kylerjkidd/Volta-Lab-Supply/README.md

# Volta-Lab-Supply
Programmable DC Power Supply
