kylerjkidd/Volta-Lab-Supply/Volta/Motherboard/REV A/Volta Block Diagram.png

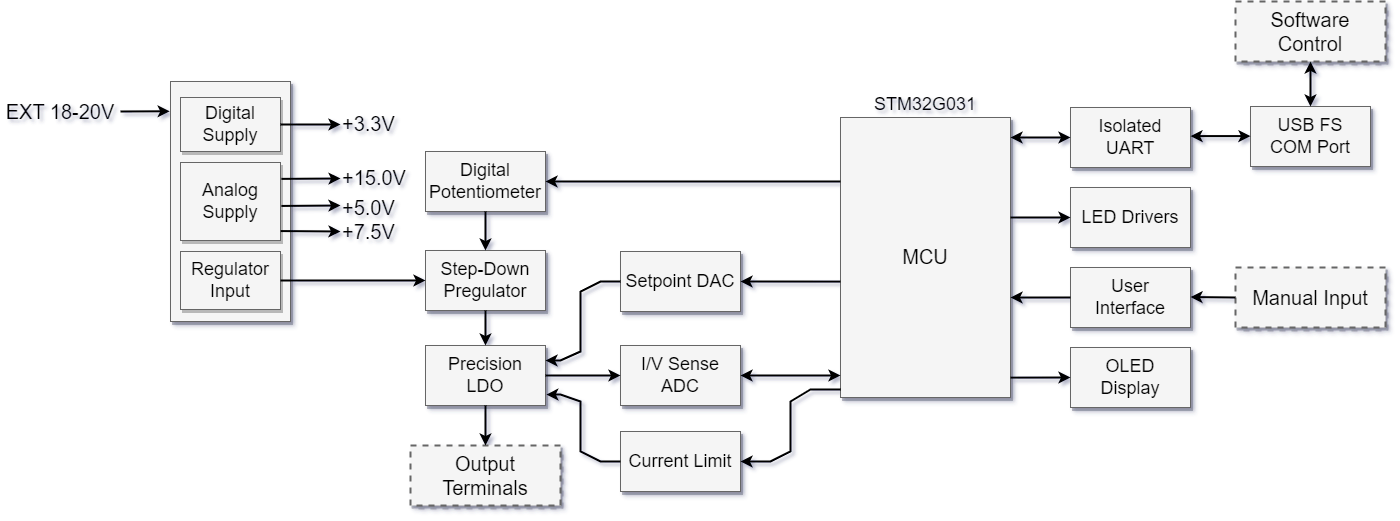
Volta/Motherboard/REV A/Volta Block Diagram.png
