kylerjkidd/Volta-Lab-Supply/Volta/Motherboard/REV A/PowerSupply-Motherboard-BOM.xlsx

Sheet: Part List Report
 |  |  | BILL OF MATERIALS |  | CIRCUIT CARD ASSEMBLY, VOLTA MOTHERBOARD
 | Part Number: |  | Volta Motherboard
 | Project: |  | "Volta Lab Bench Supply"
 | Rev: |  | A
 |  |  | Report Date: | 11/20/2022 | 2:24:57 PM
 |  |  | Print Date: | 2022-11-20 | 14:31:25
Quantity | # | Quantity | Designator | Comment | Part Number | Manufacturer | Description
5 | 1 | 5 | C1, C4, C39, C40, C43 | 10uF | GRM188C81A106MA73D | Murata Electronics | CAP CER 10UF 10V X6S 0603
16 | 2 | 16 | C2, C5, C6, C7, C9, C10, C13, C14, C15, C27, C33, C42, C44, C45, C46, C47 | 0.1uF | UMK105B7104KVHF, C0603C104K5RAC3121 | Taiyo Yuden, KEMET | CAP CER 0.1UF 50V X7R 0402, CAP CER 0.1UF 50V X7R 0603
7 | 3 | 7 | C3, C24, C30, C31, C36, C38, C41 | 4.7uF | GRM155C61E475ME15J | Murata Electronics | CAP MLCC 4.7UF 25V X5S 0402
5 | 4 | 5 | C8, C25, C26, C28, C34 | 0.01uF | HMR105B7103MV-F | Taiyo Yuden | CAP CER 0.01UF 100V X7R 0402
2 | 5 | 2 | C11, C12 | 47pF | C0402C470K5RACAUTO | KEMET | CAP CER 47PF 50V X7R 0402
10 | 6 | 10 | C16, C17, C18, C19, C20, C21, C22, C23, C29, C32 | 22uF | CL21A226MAYNNNE | Samsung Electro-Mechanics | CAP CER 22UF 25V X5R 0805
3 | 7 | 0 | C35, C37 | DNP | UMK105B7104KVHF | Taiyo Yuden | CAP CER 0.1UF 50V X7R 0402
1 | 8 | 1 | D1 | LED_Red | SM0603HCL | Bivar | LED HE RD 0603
3 | 9 | 3 | D2, D4, D6 | B240A-13-F | B240A-13-F | Diodes Incorporated | DIODE SCHOTTKY 40V 2A SMA
1 | 10 | 1 | D3 | SMAJE12AH | SMAJE12AH | Eaton - Electronics Division | TVS DIODE 12VWM UNI
1 | 11 | 1 | D5 | 1N4148 | 1N4148WS-G RVG | Taiwan Semiconductor | DIODE GEN PURP 75V 150MA SOD323
1 | 12 | 1 | D7 | BZT52-B7V5X | BZT52-B7V5X | Nexperia USA Inc. | DIODE ZENER 7.5V 590MW SOD123
1 | 13 | 1 | J1 | USB4105-GF-A | USB4105-GF-A | GCT | CONN RCP USB2.0 TYP C 24P SMD RA
2 | 14 | 2 | J2, J3 | CCSH-W10R-04TR-BK-A | CCSH-W10R-04TR-BK-A | JST | JST 4 PIN SMT CONN
1 | 15 | 1 | J4 | PJ-047A | PJ-047A | CUI Inc | CON PWR JCK 2.0 X 6.0MM W/SHLD 2.5A
1 | 16 | 1 | J5 | TSW-102-23-S-S | TSW-102-23-S-S | Samtec | CONN MALE HEADER 2 POS .100" T/H GOLD UNSHROUDED
1 | 17 | 1 | J6 | S2B-PH-SM4-TB(LF)(SN) | S2B-PH-SM4-TB(LF)(SN) | JST Sales America Inc. | CONN HEADER SMD R/A 2POS 2MM
2 | 18 | 2 | L1, L2 | 2.2uH | CIGT201610LH2R2MNE | Samsung Electro-Mechanics | FIXED IND 2.2UH 1.8A 139MOHM SMD
1 | 19 | 1 | L3 | 10uH | 74437368100 | Würth Elektronik | FIXED IND 10UH 5.2A 30 MOHM SMD
1 | 20 | 1 | L4 | 10uH | VLCF4020T-100MR85 | TDK | FIXED IND 10UH 850MA 185MOHM SMD
1 | 21 | 1 | Q1 | DMP3056L-7 | DMP3056L-7 | Diodes Incorporated | MOSFET P-CH 30V 4.3A SOT23
1 | 22 | 1 | Q2 | NPN | BCM847BV,115 | Nexperia USA | TRANS 2NPN 45V 0.1A SOT666
6 | 23 | 6 | R1, R2, R3, R33, R34, R39 | 1k | CR0402AFX-1001GLF | Bourns | RES 1K OHM 1% 1/16W 0402, RES SMD 1K OHM 1% 1/16W 0402
4 | 24 | 4 | R4, R5, R6, R7 | 2.7k | ERJ-2RKF2701X | Panasonic | RES SMD 2.7K OHM 1% 1/10W 0402
2 | 25 | 2 | R8, R11 | 27 | ERJ-2RKF27R0X | Panasonic | RES SMD 27 OHM 1% 1/10W 0402
2 | 26 | 2 | R9, R10 | 5.1k | CRCW04025K10FKED | Vishay / Dale | RES SMD 5.1K OHM 1% 1/16W 0402
2 | 27 | 2 | R12, R38 | 200k | CR0402-FX-2003GLF | Bourns | RES SMD 200K OHM 1% 1/16W 0402
4 | 28 | 4 | R13, R14, R16, R41 | 0 | CRCW04020000Z0EDC | Vishay / Dale | RES 0 OHM JUMPER 1/16W 0402
11 | 29 | 11 | R15, R20, R21, R22, R29, R35, R36, R37, R40, R46, R47 | 10k | CR0402-FX-1002GLF | Bourns | RES SMD 10K OHM 1% 1/16W 0402
2 | 30 | 0 | R17, R18 | DNP | CRCW06030000Z0EAHP | Vishay / Dale | RES SMD 0 OHM JUMPER 1/3W 0603
1 | 31 | 1 | R19 | 0.1 | ERJ-3RSFR10V | Panasonic Electronic Components | RES 0.1 OHM 1% 1/10W 0603
1 | 32 | 1 | R23 | 6.34k | ERJ-U02F6341X | Panasonic | RES SMD 6.34K OHM 1% 1/16W 0402
1 | 33 | 1 | R24 | 680 | CR0402-FX-6800GLF | Bourns | RES SMD 680 OHM 1% 1/16W 0402
 | 34 | 0 | R25 | DNP | CRCW04020000Z0EDC | Vishay / Dale | RES 0 OHM JUMPER 1/16W 0402
1 | 35 | 1 | R26 | 430 | CR0402-FX-4300GLF | Bourns Inc. | RES SMD 430 OHM 1% 1/16W 0402
1 | 36 | 1 | R27 | 10.2k | ERA-2APB1022X | Panasonic | RES SMD 10.2K OHM 0.1% 1/16W 0402
1 | 37 | 1 | R28 | 51k | ERA-2AEB513X | Panasonic | RES SMD 51K OHM 0.1% 1/16W 0402
1 | 38 | 1 | R30 | 100 | ERJ-2RKF1000X | Panasonic | RES SMD 100 OHM 1% 1/16W 0402
1 | 39 | 1 | R31 | 30.9k | ERJ-2RKF3092X | Panasonic | RES SMD 30.9K OHM 1% 1/16W 0402
1 | 40 | 1 | R32 | 59k | CRCW040259K0FKEDC | Vishay / Dale | RES SMD 59K OHM 1% 1/16W 0402
1 | 41 | 1 | R42 | 510 | RC0603FR-07510RL | YAGEO | RES 510 OHM 1% 1/10W 0603
1 | 42 | 1 | R43 | 100k | CR0402-FX-1003GLF | Bourns | RES SMD 100K OHM 1% 1/16W 0402
1 | 43 | 1 | R44 | 113k | CRCW0402113KFKED | Vishay / Dale | RES SMD 113K OHM 1% 1/16W 0402
1 | 44 | 1 | R45 | 1.2k | CR0402-FX-1201GLF | Bourns | RES SMD 1.2K OHM 1% 1/16W 0402
1 | 45 | 1 | S1 | SS312SAH4-R | SS312SAH4-R | NKK Switches | SWITCH SLIDE SPDT 0.4VA 28V
1 | 46 | 1 | U1 | SC16IS750IBS,128 | SC16IS750IBS,128 | NXP USA Inc. | IC UART I2C/SPI 24-HVQFN
1 | 47 | 1 | U2 | FT234XD | FT234XD-R | FTDI | IC USB SERIAL BASIC UART 12DFN
1 | 48 | 1 | U3 | MAX22421 | MAX22421BASA+ | Maxim Integrated | 2-CH 3KVRMS DIGITAL ISOLATOR
1 | 49 | 1 | U4 | LSF0102 | LSF0102QDCURQ1 | Texas Instruments | IC TRNSLTR BIDIRECTIONAL 8VSSOP
1 | 50 | 1 | U5 | LT3083 | LT3083EDF#PBF | Analog Devices Inc. | IC REG LINEAR POS ADJ 3A 12DFN
1 | 51 | 1 | U6 | ADP2303 | ADP2303ARDZ | Analog Devices Inc. | IC REG BUCK ADJUSTABLE 3A 8SOIC
1 | 52 | 1 | U7 | G3VM-31HR | G3VM-31HR | Omron Electronics Inc | SSR RELAY SPST-NO 4A 0-30V
1 | 53 | 1 | U8 | LMR12010 | LMR12010XMKE/NOPB | Texas Instruments | IC REG BUCK ADJ 1A TSOT23-6
1 | 54 | 1 | U9 | AD5245 | AD5245BRJZ10-R2 | Analog Devices Inc. | IC DGTL POT xKOHM 256TAP SOT23-8
2 | 55 | 2 | U10, U15 | LT1761 | LT1761ES5-BYP#TRMPBF | Linear Technology | IC REG LDO ADJ 0.1A TSOT23-5
1 | 56 | 1 | U11 | ADA4661-2 | ADA4661-2ARMZ-R7 | Analog Devices Inc. | IC CMOS 2 CIRCUIT 8MSOP
1 | 57 | 1 | U12 | MCP47CMB22 | MCP47CMB22-E/UN | Microchip Technology | IC DAC 12BIT DUAL V-OUT 10MSOP
1 | 58 | 1 | U13 | MCP1501T-20 | MCP1501T-20E/CHY | Microchip Technology | IC VREF SERIES 0.1% SOT23-6
1 | 59 | 1 | U14 | TLV431 | TLV431CDBZR | Texas Instruments | IC VREF SHUNT ADJ SOT23-3
1 | 60 | 1 | U16 | ADP121AUJZ-3.3-R7 | ADP121AUJZ-3.3-R7 | Analog Devices | IC REG LINEAR 3.3V 150MA TSOT5
1 | 61 | 1 | U17 | MCP6546 | MCP6546T-E/OT | Microchip Technology | IC COMP 1.6V SGL O-D SOT23-5
1 | 62 | 1 | U18 | INA293A | INA293A1QDBVRQ1 | Texas Instruments | IC CURR SENSE 1 CIRCUIT SOT23-5
1 | 63 | 1 | U19 | MCP3426 | MCP3426A0-E/MC | Microchip Technology | IC ADC 16BIT SIGMA-DELTA 8DFN
1 | 64 | 1 | Y1 | ASE-14.7456MHZ-LC-T | ASE-14.7456MHZ-LC-T | Abracon | XTAL OSC XO 14.7456MHZ CMOS SMD
 | 65 | 1 | N/A |  | Volta Motherboard | OSH PARK | PCB "Volta Lab Bench Supply"
 | Approved
 | Notes

Sheet: Project Information
Project Full Path | C:\Users\Implacable\Documents\Altium\_Projects\Power Supply\Motherboard\REV A\DSGN\PowerSupply-Motherboard.PrjPcb
Project Filename | PowerSupply-Motherboard.PrjPcb
Variant Name | None
Data-Source Filename | PowerSupply-Motherboard.PrjPcb
Data-Source Full Path | C:\Users\Implacable\Documents\Altium\_Projects\Power Supply\Motherboard\REV A\DSGN\PowerSupply-Motherboard.PrjPcb
Title | Bill of Materials For Project [PowerSupply-Motherboard.PrjPcb] (No PCB Document Selected)
Total Quantity | 134
Report Time | 2:24:57 PM
Report Date | 11/20/2022
Report Date & Tine | 11/20/2022 2:24:57 PM
Output Name | Bill of Materials
Output Type | BOM_PartType
Output Generator Name | BOM
Output Generator Description | Bill of Materials
