kylerjkidd/Volta-Lab-Supply/Volta/Motherboard/REV 02/PowerSupply-Motherboard-BOM.xlsx

Sheet: Part List Report
 |  |  | BILL OF MATERIALS |  | CIRCUIT CARD ASSEMBLY
 | Part Number: |  | Power Supply Motherboard
 | Project: |  | "Volta"
 | Rev: |  | 01
 |  |  | Report Date: | 8/24/2022 | 9:00:00 PM
 |  |  | Print Date: | 2022-08-25 | 20:26:04
Quantity | # | Quantity | Designator | Comment | Part Number | Manufacturer | Description
10 | 1 | 10 | C1, C9, C13, C14, C15, C16, C23, C25, C26, C36 | 2.2uF | GRM155R61E225KE11D | Murata Electronics | Multilayer Ceramic Capacitors MLCC - SMD/SMT 2.2UF 25V 10% 0402
20 | 2 | 20 | C2, C3, C4, C17, C18, C24, C27, C31, C33, C34, C38, C39, C40, C41, C42, C43, C44, C45, C46, C47 | 0.1uF | UMK105B7104KVHF | Taiyo Yuden | CAP CER 0.1UF 50V X7R 0402
5 | 3 | 5 | C5, C6, C10, C32, C35 | 0.01uF | HMR105B7103MV-F | Taiyo Yuden | CAP CER 0.01UF 100V X7R 0402
9 | 4 | 9 | C7, C8, C19, C20, C21, C22, C28, C29, C30 | 22uF | CL21A226MAYNNNE | Samsung Electro-Mechanics | CAP CER 22UF 25V X5R 0805
2 | 5 | 2 | C11, C12 | 47pF | C0402C470K5RACAUTO | KEMET | Multilayer Ceramic Capacitors MLCC - SMD/SMT 50Volt 47pF X7R 0402 10% AEC-Q200
2 | 6 | 0 | C37, R26 | DNP | UMK105B7104KVHF, CR0402-FX-1002GLF | Taiyo Yuden, Bourns | CAP CER 0.1UF 50V X7R 0402, Thick Film Resistors - SMD 10K OHM 1%
1 | 7 | 1 | D1 | 1N4148 | 1N4148WS-G RVG | Taiwan Semiconductor | Diodes - General Purpose, Power, Switching 100V, 0.15A, Switching Diode & Array
2 | 8 | 2 | D2, D9 | LED_GRN | SM0603HCL | Bivar | Standard LEDs - SMD HE Red 645 nm Water Clear
4 | 9 | 4 | D3, D5, D6, D8 | B240A-13-F | B240A-13-F | Diodes Incorporated | DIODE SCHOTTKY 40V 2A SMA
1 | 10 | 1 | D4 | BZT52-B7V5X | BZT52-B7V5X | Nexperia USA Inc. | DIODE ZENER 7.5V 590MW SOD123
1 | 11 | 1 | D7 | SMAJE12AH | SMAJE12AH | Eaton - Electronics Division | TVS DIODE 12VWM UNI
1 | 12 | 1 | F1 | 500mA PTC | MF-FSMF050X-2 | Bourns | 500mA PTC Fuse
1 | 13 | 1 | FB1 | Ferrite_Bead | BLM18AG102SH1D | Murata Electronics | Ferrite Beads 1000 OHM 25%
1 | 14 | 1 | J1 | USB4105-GF-A | USB4105-GF-A | GCT | USB-C (USB TYPE-C) USB 2.0 Receptacle Connector 24 (16+8 Dummy) Position Surface Mount, Right Angle; Through Hole
1 | 15 | 1 | J2 | PJ-047A | PJ-047A | CUI Inc | CON PWR JCK 2.0 X 6.0MM W/SHLD 2.5A
2 | 16 | 2 | J3, J7 | CCSH-W10R-04TR-BK-A | CCSH-W10R-04TR-BK-A | JST
1 | 17 | 1 | J4 | JST-PH-SMT
1 | 18 | 1 | J5 | TSW-102-xx-L-S | TSW-102-xx-L-S | Samtec | CONN MALE HEADER 2 POS .100" T/H GOLD UNSHROUDED
1 | 19 | 0 | J6 | DNP | 801-93-006-10-012000 | Mill-Max | CONN SOCKET STRIP LOPRO 6POS
1 | 20 | 1 | L1 | 10uH | VLCF4020T-100MR85 | TDK | Fixed Inductors 10uH 0.85A 4x4x2.0mm
2 | 21 | 2 | L2, L3 | 2.2uH | CIGT201610LH2R2MNE | Samsung Electro-Mechanics | FIXED IND 2.2UH 1.8A 139MOHM SMD
1 | 22 | 1 | L4 | 10uH | 74437368100 | Würth Elektronik | FIXED IND 10UH 5.2A 30 MOHM SMD
1 | 23 | 1 | Q1 | DMP3056L-7 | DMP3056L-7 | Diodes Incorporated | MOSFET P-CH 30V 4.3A SOT23
1 | 24 | 1 | Q2 | NPN | BCM847BV,115 | Nexperia USA | TRANS 2NPN 45V 0.1A SOT666
7 | 25 | 7 | R1, R28, R30, R32, R33, R36, R40 | 1k | CR0402AFX-1001GLF | Bourns | Thick Film Resistors - SMD Resistor 0402 1k 1% 63mW TC100, Thick Film Resistors - SMD ResA 0402 1k 1% 63mW TC100
1 | 26 | 1 | R2 | 30.9k | ERJ-2RKF3092X | Panasonic | Thick Film Resistors - SMD 0402 30.9Kohms 1% AEC-Q200
1 | 27 | 1 | R3 | 59k | CRCW040259K0FKEDC | Vishay / Dale | Thick Film Resistors - SMD 1/16watt 59K ohms 1% Commercial Use
12 | 28 | 12 | R4, R6, R10, R14, R15, R20, R21, R35, R39, R42, R49, R50 | 10k | CR0402-FX-1002GLF | Bourns | Thick Film Resistors - SMD 10K OHM 1%
2 | 29 | 2 | R5, R9 | 27 | ERJ-2RKF27R0X | Panasonic | Thick Film Resistors - SMD 0402 27.0ohms 1% Tol AEC-Q200
2 | 30 | 2 | R7, R8 | 5.1k | CRCW04025K10FKED | Vishay / Dale | Thick Film Resistors - SMD 1/16watt 5.1Kohms 1%
1 | 31 | 1 | R11 | 510 | RC0603FR-07510RL | YAGEO | Thick Film Resistors - SMD 510 Ohms 100mW 0603 1%
1 | 32 | 1 | R12 | 0 | CRCW04020000Z0EDC | Vishay / Dale | Thick Film Resistors - SMD 1/16watt 0ohm Commercial Use
1 | 33 | 1 | R13 | 113k | CRCW0402113KFKED | Vishay / Dale | Thick Film Resistors - SMD 1/16 Watt 113K ohms 1%
1 | 34 | 1 | R16 | 0.5 | PT1206FR-7W0R5L | YAGEO | Current Sense Resistors - SMD 500 mOhms 500mW 1 % 75 ppm/C AEC-Q200
4 | 35 | 4 | R17, R18, R43, R44 | 2.7k | ERJ-2RKF2701X | Panasonic | Thick Film Resistors - SMD 0402 2.7Kohms 1% AEC-Q200
2 | 36 | 2 | R19, R31 | 24k | RT0402BRD0724KL | YAGEO | Thin Film Resistors - SMD 1/16W 24K ohm 0.1% 25ppm
1 | 37 | 1 | R22 | 9.1k | ERA-2AEB912X | Panasonic | Thin Film Resistors - SMD 0402 1/16W 9.1Kohms
2 | 38 | 2 | R23, R34 | 10.2k | ERA-2APB1022X | Panasonic | Thin Film Resistors - SMD 0402 10.2Kohms 0.1% .063W 15ppm AEC-Q200
5 | 39 | 5 | R24, R37, R38, R41, R45 | 51k | ERA-2AEB513X | Panasonic | Thin Film Resistors - SMD 0402 1/16W 51Kohms 0.1%
1 | 40 | 1 | R25 | 6.34k | ERJ-U02F6341X | Panasonic | Thick Film Resistors - SMD 0402 1% 6.34Kohm Anti-Sulfur AEC-Q200
1 | 41 | 1 | R27 | 680 | CR0402-FX-6800GLF | Bourns | Thick Film Resistors - SMD 680 OHM 1%
1 | 42 | 1 | R29 | 100 | ERJ-2RKF1000X | Panasonic | Thick Film Resistors - SMD 0402 100ohms 1% AEC-Q200
2 | 43 | 2 | R46, R47 | 10 | ESR01MZPF10R0 | ROHM Semiconductor | Thick Film Resistors - SMD 0402 10ohm 1% Anti Surge AEC-Q200
1 | 44 | 1 | R48 | 56k | CR0402-FX-5602GLF | Bourns | Thick Film Resistors - SMD 56K OHM 1%
1 | 45 | 1 | S1 | SS312SAH4-R | SS312SAH4-R | NKK Switches | Slide Switch SPDT Surface Mount, Right Angle
1 | 46 | 1 | S2 | KMR243GLFG | KMR243GFLG | C&K | Tactile Switch SPST-NO Top Actuated Surface Mount
1 | 47 | 1 | U1 | LMR12010 | LMR12010XMKE/NOPB | Texas Instruments | IC REG BUCK ADJ 1A TSOT23-6
2 | 48 | 2 | U2, U6 | LT1761 | LT1761ES5-BYP#TRMPBF | Linear Technology | IC REG LDO ADJ 0.1A TSOT23-5
1 | 49 | 1 | U3 | USBLC6 | USBLC6-2SC6 | STMicroelectronics | IC ESD PROTECTION LO CAP SOT23-6
1 | 50 | 1 | U4 | FT234XD | FT234XD-R | FTDI | IC USB SERIAL BASIC UART 12DFN
1 | 51 | 1 | U5 | MAX22421 | MAX22421BASA+ | Maxim Integrated | 2-CH 3KVRMS DIGITAL ISOLATOR
1 | 52 | 1 | U7 | ADP121AUJZ-3.3-R7 | ADP121AUJZ-3.3-R7 | Analog Devices | IC REG LINEAR 3.3V 150MA TSOT5
1 | 53 | 1 | U8 | LT3083 | LT3083EDF#PBF | Analog Devices Inc. | Linear Voltage Regulator IC Positive Adjustable 1 Output 3A 12-DFN (4x4)
1 | 54 | 1 | U9 | ADP2303 | ADP2303ARDZ | Analog Devices Inc. | IC REG BUCK ADJUSTABLE 3A 8SOIC
1 | 55 | 1 | U10 | STM32G031F6P6 | STM32G031F6P6 | STMicroelectronics | IC MCU 32BIT 32KB FLASH 20TSSOP
1 | 56 | 1 | U11 | MCP6L2T | MCP6L2T-E/MS | Microchip Technology | IC OPAMP GP 2 CIRCUIT 8MSOP
1 | 57 | 1 | U12 | AD5245 | AD5245BRJZ10-R2 | Analog Devices Inc. | Digital Potentiometer 10k Ohm 1 Circuit 256 Taps I²C Interface SOT-23-8
1 | 58 | 1 | U13 | ADA4661-2 | ADA4661-2ARMZ-R7 | Analog Devices Inc. | IC CMOS 2 CIRCUIT 8MSOP
1 | 59 | 1 | U14 | MCP1501T-20 | MCP1501T-20E/CHY | Microchip Technology | IC VREF SERIES 0.1% SOT23-6
1 | 60 | 1 | U15 | MCP47CVB21 | MCP47CVB21-E/UN | Microchip Technology | IC DAC 12BIT V-OUT 10MSOP
1 | 61 | 1 | U16 | MCP9804 | MCP9804T-E/MC | Microchip Technology | SENSOR DIGITAL -40C-125C 8DFN
1 | 62 | 1 | U17 | MCP6546 | MCP6546T-E/OT | Microchip Technology | IC COMP 1.6V SGL O-D SOT23-5
1 | 63 | 1 | U18 | INA219 | INA219AIDCNR | Texas Instruments | Current Monitor Regulator High-Side 10mA SOT-23-8
1 | 64 | 1 | Y1 | ASE-12.000-MHZ-E-T | ASE-12.000-MHZ-E-T | Abracon | OSC XO 12.000MHZ CMOS SMD
 | 65 | 1 | N/A |  | Power Supply Motherboard | OSH PARK | PCB "Volta"
 | Approved
 | Notes

Sheet: Project Information
Project Full Path | C:\Users\Implacable\Documents\Altium\_Projects\Power Supply\Motherboard\DSGN\PowerSupply-Motherboard.PrjPcb
Project Filename | PowerSupply-Motherboard.PrjPcb
Variant Name | None
Data-Source Filename | PowerSupply-Motherboard.PrjPcb
Data-Source Full Path | C:\Users\Implacable\Documents\Altium\_Projects\Power Supply\Motherboard\DSGN\PowerSupply-Motherboard.PrjPcb
Title | Bill of Materials For Project [PowerSupply-Motherboard.PrjPcb] (No PCB Document Selected)
Total Quantity | 146
Report Time | 9:00:00 PM
Report Date | 8/24/2022
Report Date & Tine | 8/24/2022 9:00:00 PM
Output Name | Bill of Materials
Output Type | BOM_PartType
Output Generator Name | BOM
Output Generator Description | Bill of Materials
