kylerjkidd/Volta-Lab-Supply/Volta/Interface/REV 02/Volta-Interface.xlsx

Sheet: Part List Report
 |  |  | BILL OF MATERIALS |  | CIRCUIT CARD ASSEMBLY
 | Part Number: |  | Volta-Interface
 | Project: |  | Volta Front Panel Interface
 | Rev: |  | 02
 |  |  | Report Date: | 10/7/2023 | 5:27 PM
 |  |  | Print Date: | 2023-10-08 | 11:28:17
Quantity | # | Quantity | Designator | Comment | Part Number | Manufacturer | Description
12 | 1 | 12 | C1, C3, C4, C5, C6, C7, C10, C11, C12, C13, C15, C18 | 2.2uF | GRM155R61E225KE11D, GRM188C81A106MA73D | Murata Electronics | Multilayer Ceramic Capacitors MLCC - SMD/SMT 2.2UF 25V 10% 0402, CAP CER 10UF 10V X6S 0603
3 | 2 | 3 | C2, C14, C16 | 0.1uF | UMK105B7104KVHF | Taiyo Yuden | CAP CER 0.1UF 50V X7R 0402
3 | 3 | 3 | C8, C9, C17 | 0.01uF | HMR105B7103MV-F | Taiyo Yuden | CAP CER 0.01UF 100V X7R 0402
1 | 4 | 1 | C19 | 10uF | GRM188C81A106MA73D | Murata Electronics | CAP CER 10UF 10V X6S 0603
3 | 5 | 3 | D1, D2, D3 | LED |  |  | LED
1 | 6 | 1 | D4 | LED_GRN | SM0603HCL | Bivar | Standard LEDs - SMD HE Red 645 nm Water Clear
1 | 7 | 1 | J1 | CCSH-W10R-04TR-BK-A | CCSH-W10R-04TR-BK-A | JST
1 | 8 | 1 | J2 | ER-CON30HT-1 | ER-CON30HT-1 | EastRising Technology | 30 PINS 0.5 PITCH SMD TOP CONTACT CONN
1 | 9 | 0 | J3 | DNP | 801-93-006-10-012000 | Mill-Max | CONN SOCKET STRIP LOPRO 6POS
2 | 10 | 0 | R1, R2 | DNP | CRCW04020000Z0EDC | Vishay / Dale | Thick Film Resistors - SMD 1/16watt 0ohm Commercial Use
8 | 11 | 8 | R3, R4, R5, R6, R7, R8, R12, R13 | 10k | CR0402-FX-1002GLF, KTR03EZPJ512 | Bourns, ROHM Semiconductor | Thick Film Resistors - SMD 10K OHM 1%, Thick Film Resistors - SMD 0603 5.1Kohm 5% High Voltage
2 | 12 | 2 | R9, R10 | 2.7k | ERJ-2RKF2701X | Panasonic | Thick Film Resistors - SMD 0402 2.7Kohms 1% AEC-Q200
1 | 13 | 1 | R11 | 1k | CR0402AFX-1001GLF | Bourns | Thick Film Resistors - SMD ResA 0402 1k 1% 63mW TC100
1 | 14 | 1 | R14 | 390k | KTR03EZPJ512 | ROHM Semiconductor | Thick Film Resistors - SMD 0603 5.1Kohm 5% High Voltage
3 | 15 | 3 | S1, S3, S4 | B3F-105X | B3F-105X | Omron Electronics Inc-EMC Div | SWITCH TACTILE SPST-NO 0.05A 24V
1 | 16 | 1 | S2 | PEC11R-4115F-S0018 | PEC11R-4115F-S0018 | Bourns | ROTARY ENCODER MECHANICAL XXPPR
1 | 17 | 1 | S5 | KMR243GLFG | KMR243GFLG | C&K | Tactile Switch SPST-NO Top Actuated Surface Mount
1 | 18 | 1 | U1 | IS31FL3193 | IS31FL3193-DLS2-TR | Lumissil Microsystems | IC LED DRIVER LINEAR 42MA 10DFN
1 | 19 | 1 | U2 | STM32G031F6P6 | STM32G031F6P6 | STMicroelectronics | IC MCU 32BIT 32KB FLASH 20TSSOP
1 | 20 | 1 | Y1 | ASE-12.000-MHZ-E-T | ASE-12.000-MHZ-E-T | Abracon | OSC XO 12.000MHZ CMOS SMD
 | 21 | 1 | N/A |  | Volta-Interface | OCEAN INSIGHT | PCB Volta Front Panel Interface
 | Approved
 | Notes

Sheet: Project Information
Project Full Path | C:\Users\Implacable\Documents\_Github\Volta\Interface\REV 01\Volta-Inteface.PrjPcb
Project Filename | Volta-Inteface.PrjPcb
Variant Name | None
Data-Source Filename | Volta-Inteface.PrjPcb
Data-Source Full Path | C:\Users\Implacable\Documents\_Github\Volta\Interface\REV 01\Volta-Inteface.PrjPcb
Title | Bill of Materials for Project [Volta-Inteface.PrjPcb] (No PCB Document Selected)
Total Quantity | 48
Report Time | 5:27 PM
Report Date | 10/7/2023
Report Date & Tine | 10/7/2023 5:27 PM
Output Name | Bill of Materials
Output Type | BomReport
Output Generator Name | BOM
Output Generator Description | Bill of Materials
