kylerjkidd/Volta-Lab-Supply/Volta/Interface/REV A/Volta-Interface.xlsx

Sheet: Part List Report
 |  |  | BILL OF MATERIALS |  | CIRCUIT CARD ASSEMBLY
 | Part Number: |  | Volta-Interface
 | Project: |  | Volta Front Panel Interface
 | Rev: |  | A
 |  |  | Report Date: | 10/8/2023 | 2:31 PM
 |  |  | Print Date: | 2023-10-08 | 11:33:11
Quantity | # | Quantity | Designator | Comment | Part Number | Manufacturer | Description
10 | 1 | 10 | C1, C3, C6, C8, C14, C15, C16, C17, C19, C23 | 2.2uF | GRM155R61E225KE11D | Murata Electronics | CAP CER 2.2UF 25V X5R 0402
10 | 2 | 10 | C2, C4, C5, C7, C9, C10, C11, C18, C20, C21 | 0.1uF | UMK105B7104KVHF, GRM155R61E225KE11D | Taiyo Yuden | CAP CER 0.1UF 50V X7R 0402
3 | 3 | 3 | C12, C13, C22 | 0.01uF | HMR105B7103MV-F | Taiyo Yuden | CAP CER 0.01UF 100V X7R 0402
1 | 4 | 1 | C24 | 10uF | CL05A106MP8NUB8 | Samsung Electro-Mechanics | CAP CER 10UF 10V X5R 0402
2 | 5 | 2 | D1, D4 | XZMOK53W-8 | XZMOK53W-8 | SunLED | LED ORANGE CLEAR CHIP SMD
2 | 6 | 2 | D2, D5 | XZM2ACR53W-8 | XZM2ACR53W-8 | SunLED | LED RED CLEAR CHIP SMD
2 | 7 | 2 | D3, D6 | XZVG53W-8 | XZVG53W-8 | SunLED | LED GREEN CLEAR CHIP SMD
1 | 8 | 1 | D7 | LED_Red | SM0603HCL | Bivar | LED HE RD 0603
1 | 9 | 1 | J1 | CCSH-W10R-04TR-BK-A | CCSH-W10R-04TR-BK-A | JST | JST 4 PIN SMT CONN
1 | 10 | 1 | J2 | ER-CON30HT-1 | ER-CON30HT-1 | EastRising Technology | 30 PINS 0.5 PITCH SMD TOP CONTACT CONN
5 | 11 | 5 | R1, R2, R3, R4, R11 | 100 | ERJ-2RKF1000X | Panasonic | RES SMD 100 OHM 1% 1/16W 0402
2 | 12 | 0 | R5, R8 | DNP | CRCW04020000Z0EDC | Vishay / Dale | RES 0 OHM JUMPER 1/16W 0402
7 | 13 | 7 | R6, R7, R9, R10, R14, R16, R17 | 10k | CR0402-FX-1002GLF | Bourns | RES SMD 10K OHM 1% 1/16W 0402
2 | 14 | 2 | R12, R13 | 2.7k | ERJ-2RKF2701X | Panasonic | RES SMD 2.7K OHM 1% 1/10W 0402
1 | 15 | 1 | R15 | 1k | CR0402AFX-1001GLF | Bourns | RES 1K OHM 1% 1/16W 0402
1 | 16 | 1 | R18 | 390k | CR0402-FX-3903GLF | Bourns Inc. | RES SMD 390K OHM 1% 1/16W 0402
4 | 17 | 4 | S1, S2, S3, S4 | B3F-105X | B3F-105X | Omron Electronics Inc-EMC Div | SWITCH TACTILE SPST-NO 0.05A 24V
1 | 18 | 1 | S5 | PEC11R-4115F-S0018 | PEC11R-4115F-S0018 | Bourns | ROTARY ENCODER MECHANICAL XXPPR
1 | 19 | 1 | S6 | KMR243GLFG | KMR243GLFG | C&K | SWITCH TACTILE SPST-NO 0.01A 32V
2 | 20 | 2 | U1, U2 | IS31FL3193 | IS31FL3193-DLS2-TR | Lumissil Microsystems | IC LED DRIVER LINEAR 42MA 10DFN
1 | 21 | 1 | U3 | STM32G031F8P6 | STM32G031F8P6 | STMicroelectronics | IC MCU 32BIT 64KB FLASH 20TSSOP
1 | 22 | 1 | Y1 | ASE-10.000MHZ-LC-T | ASE-10.000MHZ-LC-T | Abracon | OSC XO 10.000MHZ CMOS SMD
 | 23 | 1 | N/A |  | Volta-Interface |  | PCB Volta Front Panel Interface
 | Approved
 | Notes

Sheet: Project Information
Project Full Path | C:\Users\Implacable\Documents\_Github\Volta\Interface\REV A\DSGN\Volta-Inteface.PrjPcb
Project Filename | Volta-Inteface.PrjPcb
Variant Name | None
Data-Source Filename | Volta-Inteface.PrjPcb
Data-Source Full Path | C:\Users\Implacable\Documents\_Github\Volta\Interface\REV A\DSGN\Volta-Inteface.PrjPcb
Title | Bill of Materials for Project [Volta-Inteface.PrjPcb] (No PCB Document Selected)
Total Quantity | 61
Report Time | 2:31 PM
Report Date | 10/8/2023
Report Date & Tine | 10/8/2023 2:31 PM
Output Name | Bill of Materials
Output Type | BomReport
Output Generator Name | BOM
Output Generator Description | Bill of Materials
