kylerjkidd/Volta-Lab-Supply/Volta/Motherboard/REV 02/Changes.docx

Changes from Volta-Motherboard Rev 01

- Adjusted the front facing board outline to support larger front panel CCA
- Changed U10 to STM32G031F8P6 to increase program flash
- Changed U15 to MCP47CMB22 to improve the DC precision and resolution of the current limit setpoint
- ILIM now comes from a dedicated DAC
- MCP6L2T replaced with TLV272 due to product availability
- Current sense resistor value changed to 0.33 Ohm
- Differential amplifier gain increased to 10V/V
