kylerjkidd/Volta-Lab-Supply/Volta/Interface/REV 02/Changes.docx

Changes from Volta-Interface Rev 01

- Increased board dimensions to 90x26mm
- Increased clearances around the rotary encoder
- Shifted position of binding posts, encoder and switches
- Reduced backplane drill size for binding posts
- Adjusted display connector position and increased clearance
- Added soft-start capacitor to the reset line on the display
- Changed U2 to STM32G031F8P6 to increase program flash
