kylerjkidd/Volta-Lab-Supply/Volta/Interface/REV A/Changes.docx

Changes from Volta-Interface Rev 02

- Added additional trim adjust button
- Shifted position of buttons to fit additional button
- Moved to 4 layers to improve routing
- Additional LEDs fitted for more indicator lights (FAULT/CLAMP, SET MODE, SERIAL)
- Added series resistors to debounce capacitors to protect switch terminals
- Removed extraneous bias resistor
- Added support for Tag-Connect programming cable
