kylerjkidd/Volta-Lab-Supply/Volta/Prototyping/Volta-Digital-SCH_(01).pdf

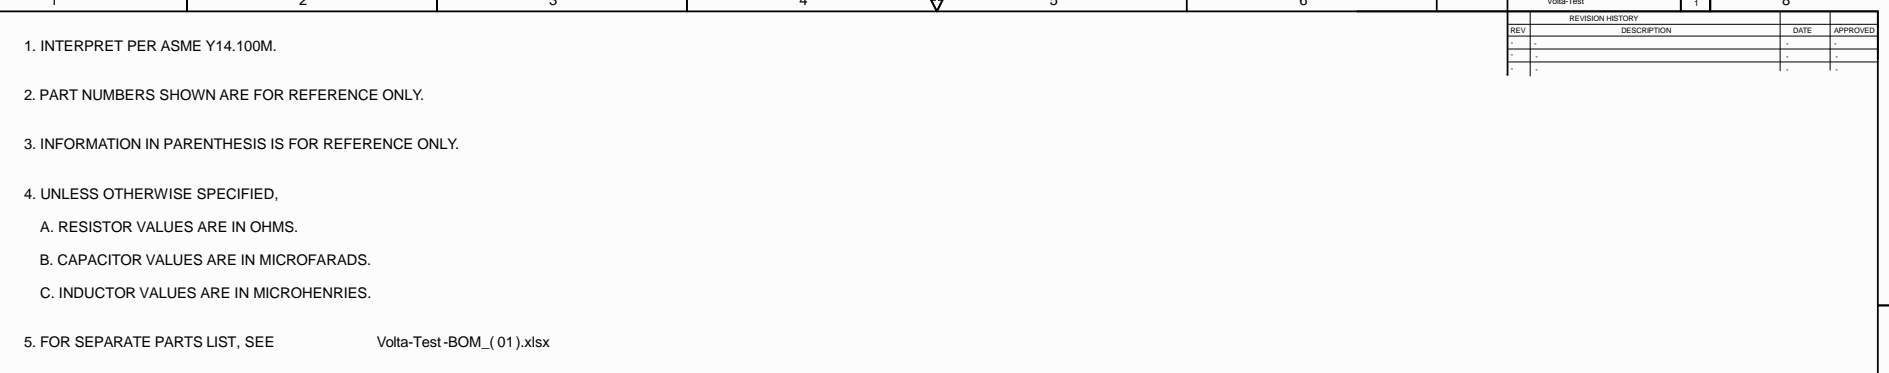
[picture p2: page 1]

DWG NO Volta-Test | SH

REVISION HISTORY

REV | DESCRIPTION | DATE | APPROVED
- | - | - -

2. PART NUMBERS SHOWN ARE FOR REFERENCE ONLY.

3. INFORMATION IN PARENTHESIS IS FOR REFERENCE ONLY.

A. RESISTOR VALUES ARE IN OHMS.

B. CAPACITOR VALUES ARE IN MICROFARADS.

C. INDUCTOR VALUES ARE IN MICROHENRIES.

5. FOR SEPARATE PARTS LIST, SEE

MATERIAL: | DO NOT SCALE DRAWING UNLESS OTHERWISE SPECIFIED, DIMENSIONS ARE IN TOLERANCES: .X +/- 0.1 .XX +/- 0.01 .XXX +/- 0.001 | DFTG | K. KIDD | -

ENG | K. KIDD | -
MECH | * | *

MFG | * | *

THIRD ANGLE PROJECTION | ALL SHEETS ARE THE SAME REVISION STATUS

SIZE D | DRAWING NUMBER Volta-Test | REV 01

SCALE N/A | | 1 3 SHEET OF

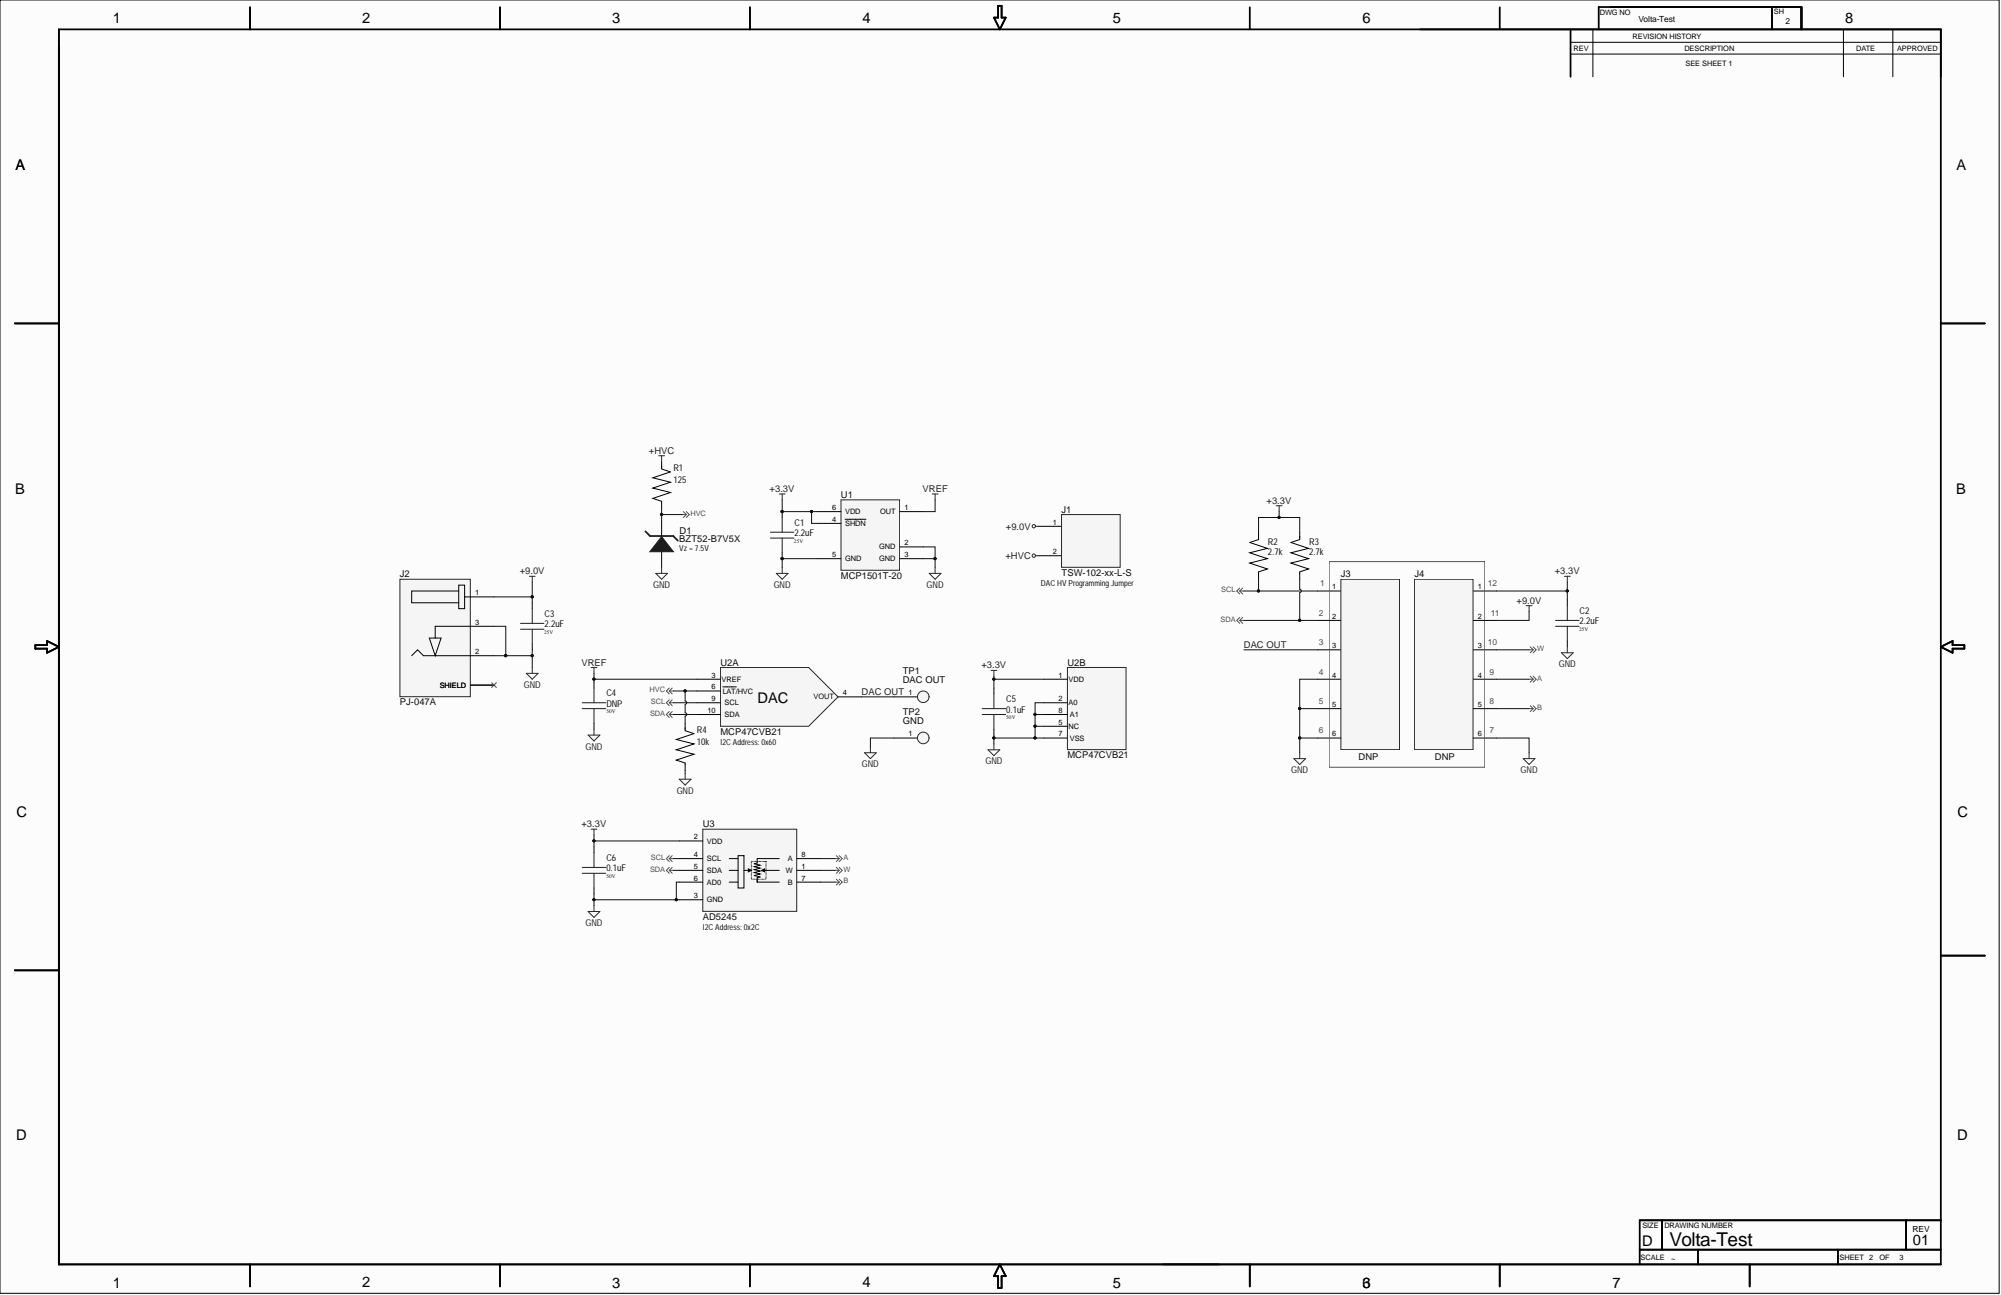
[picture p3: page 2]

D W G N O Volta-Tes t | SH 2

REVISI O N H IST O R Y

REV | DESC R IPTI O N | D ATE | APPR OVED

DAC HV Programming Jumper

SIZE D | G D R AW I N N U MBER | REV

SCALE ~ | | 2 SHEET O F
