kylerjkidd/Volta-Lab-Supply/Volta/Prototyping/Volta-Display-SCH_(01).pdf

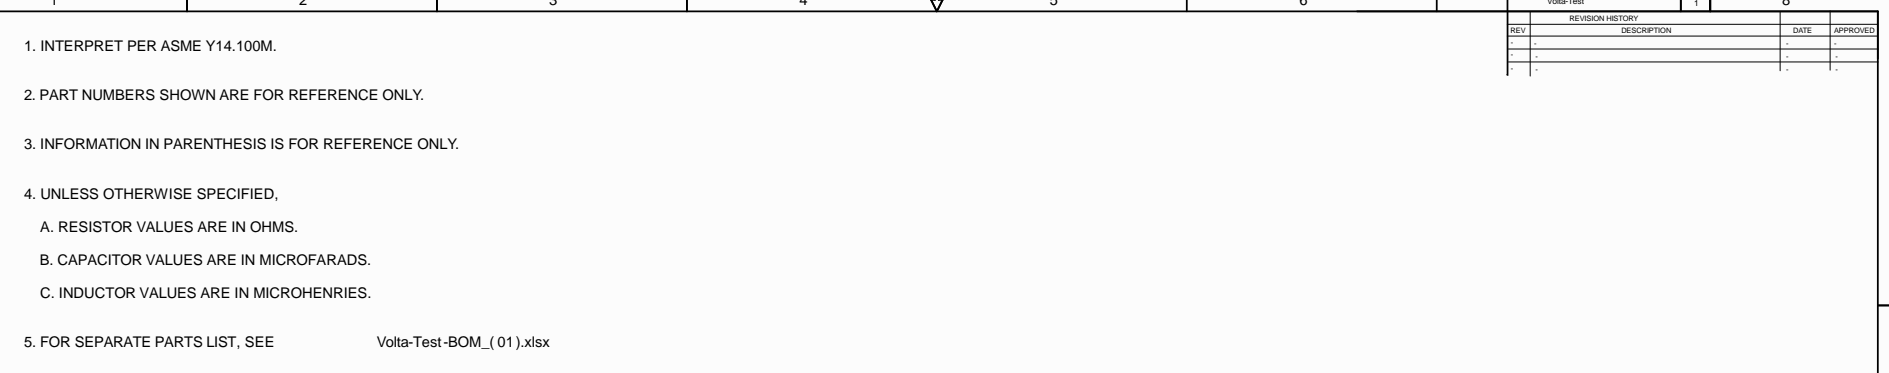
[picture p4: page 1]

DWG NO Volta-Test | SH

REVISION HISTORY

REV | DESCRIPTION | DATE | APPROVED
- | - | - -

2. PART NUMBERS SHOWN ARE FOR REFERENCE ONLY.

3. INFORMATION IN PARENTHESIS IS FOR REFERENCE ONLY.

A. RESISTOR VALUES ARE IN OHMS.

B. CAPACITOR VALUES ARE IN MICROFARADS.

C. INDUCTOR VALUES ARE IN MICROHENRIES.

5. FOR SEPARATE PARTS LIST, SEE

MATERIAL: | DO NOT SCALE DRAWING UNLESS OTHERWISE SPECIFIED, DIMENSIONS ARE IN TOLERANCES: .X +/- 0.1 .XX +/- 0.01 .XXX +/- 0.001 | DFTG | K. KIDD | -

ENG | K. KIDD | -
MECH | * | *

MFG | * | *

THIRD ANGLE PROJECTION | ALL SHEETS ARE THE SAME REVISION STATUS

SIZE D | DRAWING NUMBER Volta-Test | REV 01

SCALE N/A | | 1 3 SHEET OF

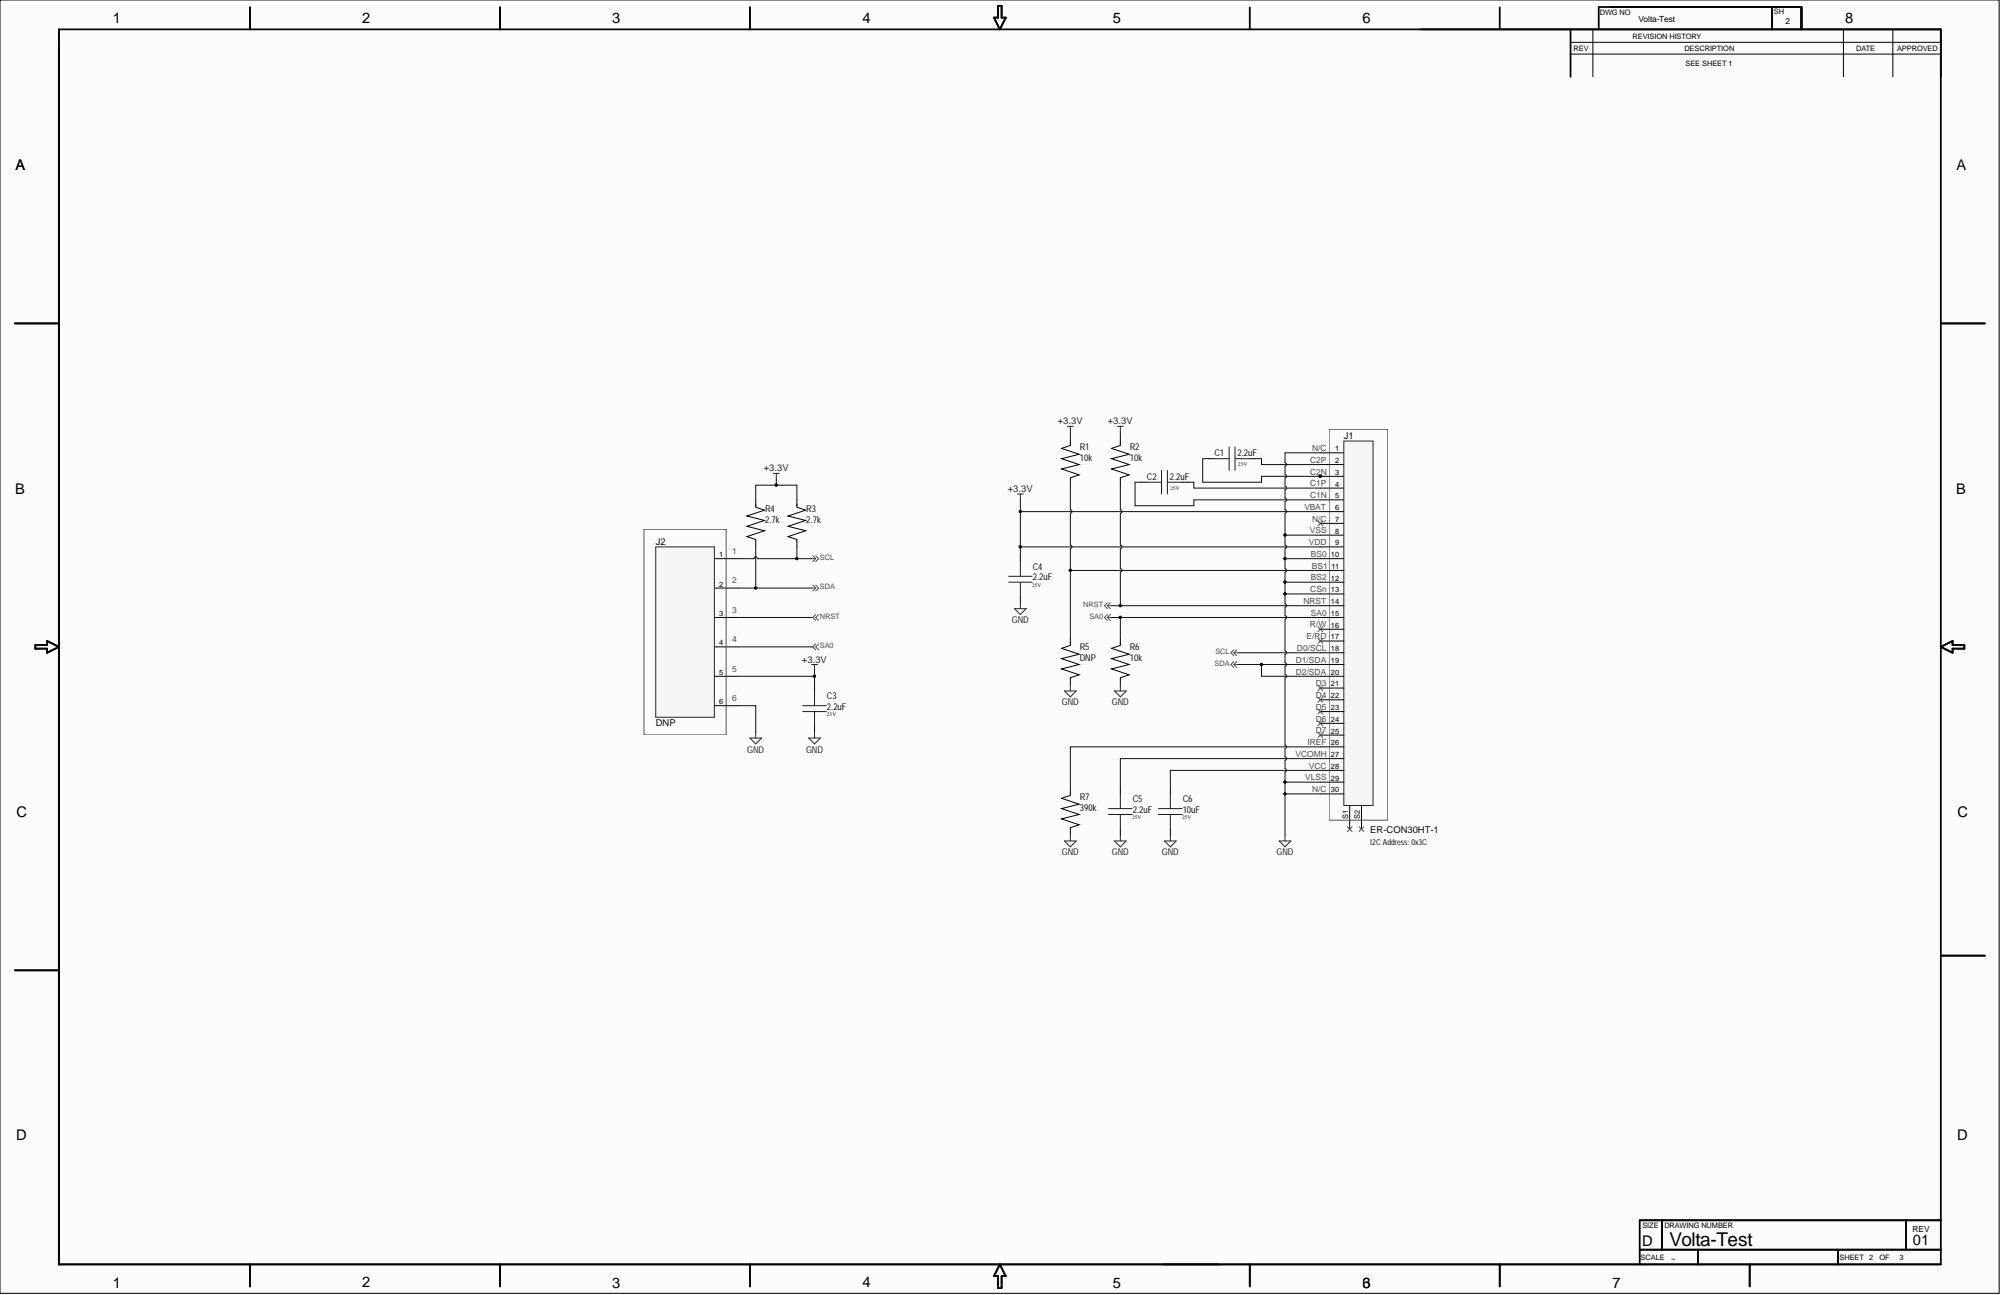
[picture p5: page 2]

D W G N O Volta-Tes t | SH 2

REVISI O N H IST O R Y

REV | DESC R IPTI O N | D ATE | APPR OVED

C2P
C2N
C1P
C1N

N/C VSS

VDD
BS0 | 1011
BS1
BS2 | 12
CSn | 13
14 15 16

D1/SDA | 19
D2/SDA | 20
D3 IREF | 21

VCOMH | 27
VCC | 28
VLSS | 29
N/C
30

SIZE D | G D R AW I N N U MBER | REV

SCALE ~ | | 2 SHEET O F
