kylerjkidd/Volta-Lab-Supply/Volta/Prototyping/Volta-Interposer-SCH_(01).pdf

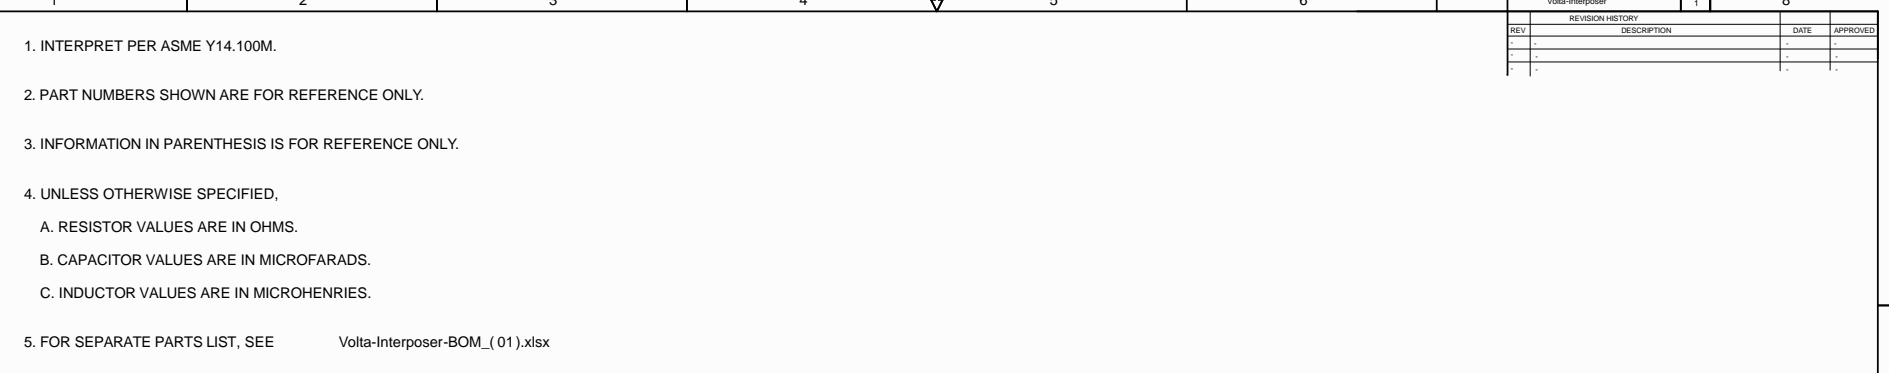
[picture p6: page 1]

DWG NO Volta-Interposer | SH

REVISION HISTORY

REV | DESCRIPTION | DATE | APPROVED
- | - | - -

2. PART NUMBERS SHOWN ARE FOR REFERENCE ONLY.

3. INFORMATION IN PARENTHESIS IS FOR REFERENCE ONLY.

A. RESISTOR VALUES ARE IN OHMS.

B. CAPACITOR VALUES ARE IN MICROFARADS.

C. INDUCTOR VALUES ARE IN MICROHENRIES.

5. FOR SEPARATE PARTS LIST, SEE

MATERIAL: | DO NOT SCALE DRAWING UNLESS OTHERWISE SPECIFIED, DIMENSIONS ARE IN TOLERANCES: .X +/- 0.1 .XX +/- 0.01 .XXX +/- 0.001 | DFTG | K. KIDD | 10/09/2022

ENG | K. KIDD | 10/09/2022
MECH | * | *

MFG | * | *

THIRD ANGLE PROJECTION | ALL SHEETS ARE THE SAME REVISION STATUS

SIZE D | DRAWING NUMBER Volta-Interposer | REV 01

SCALE N/A | | 1 3 SHEET OF

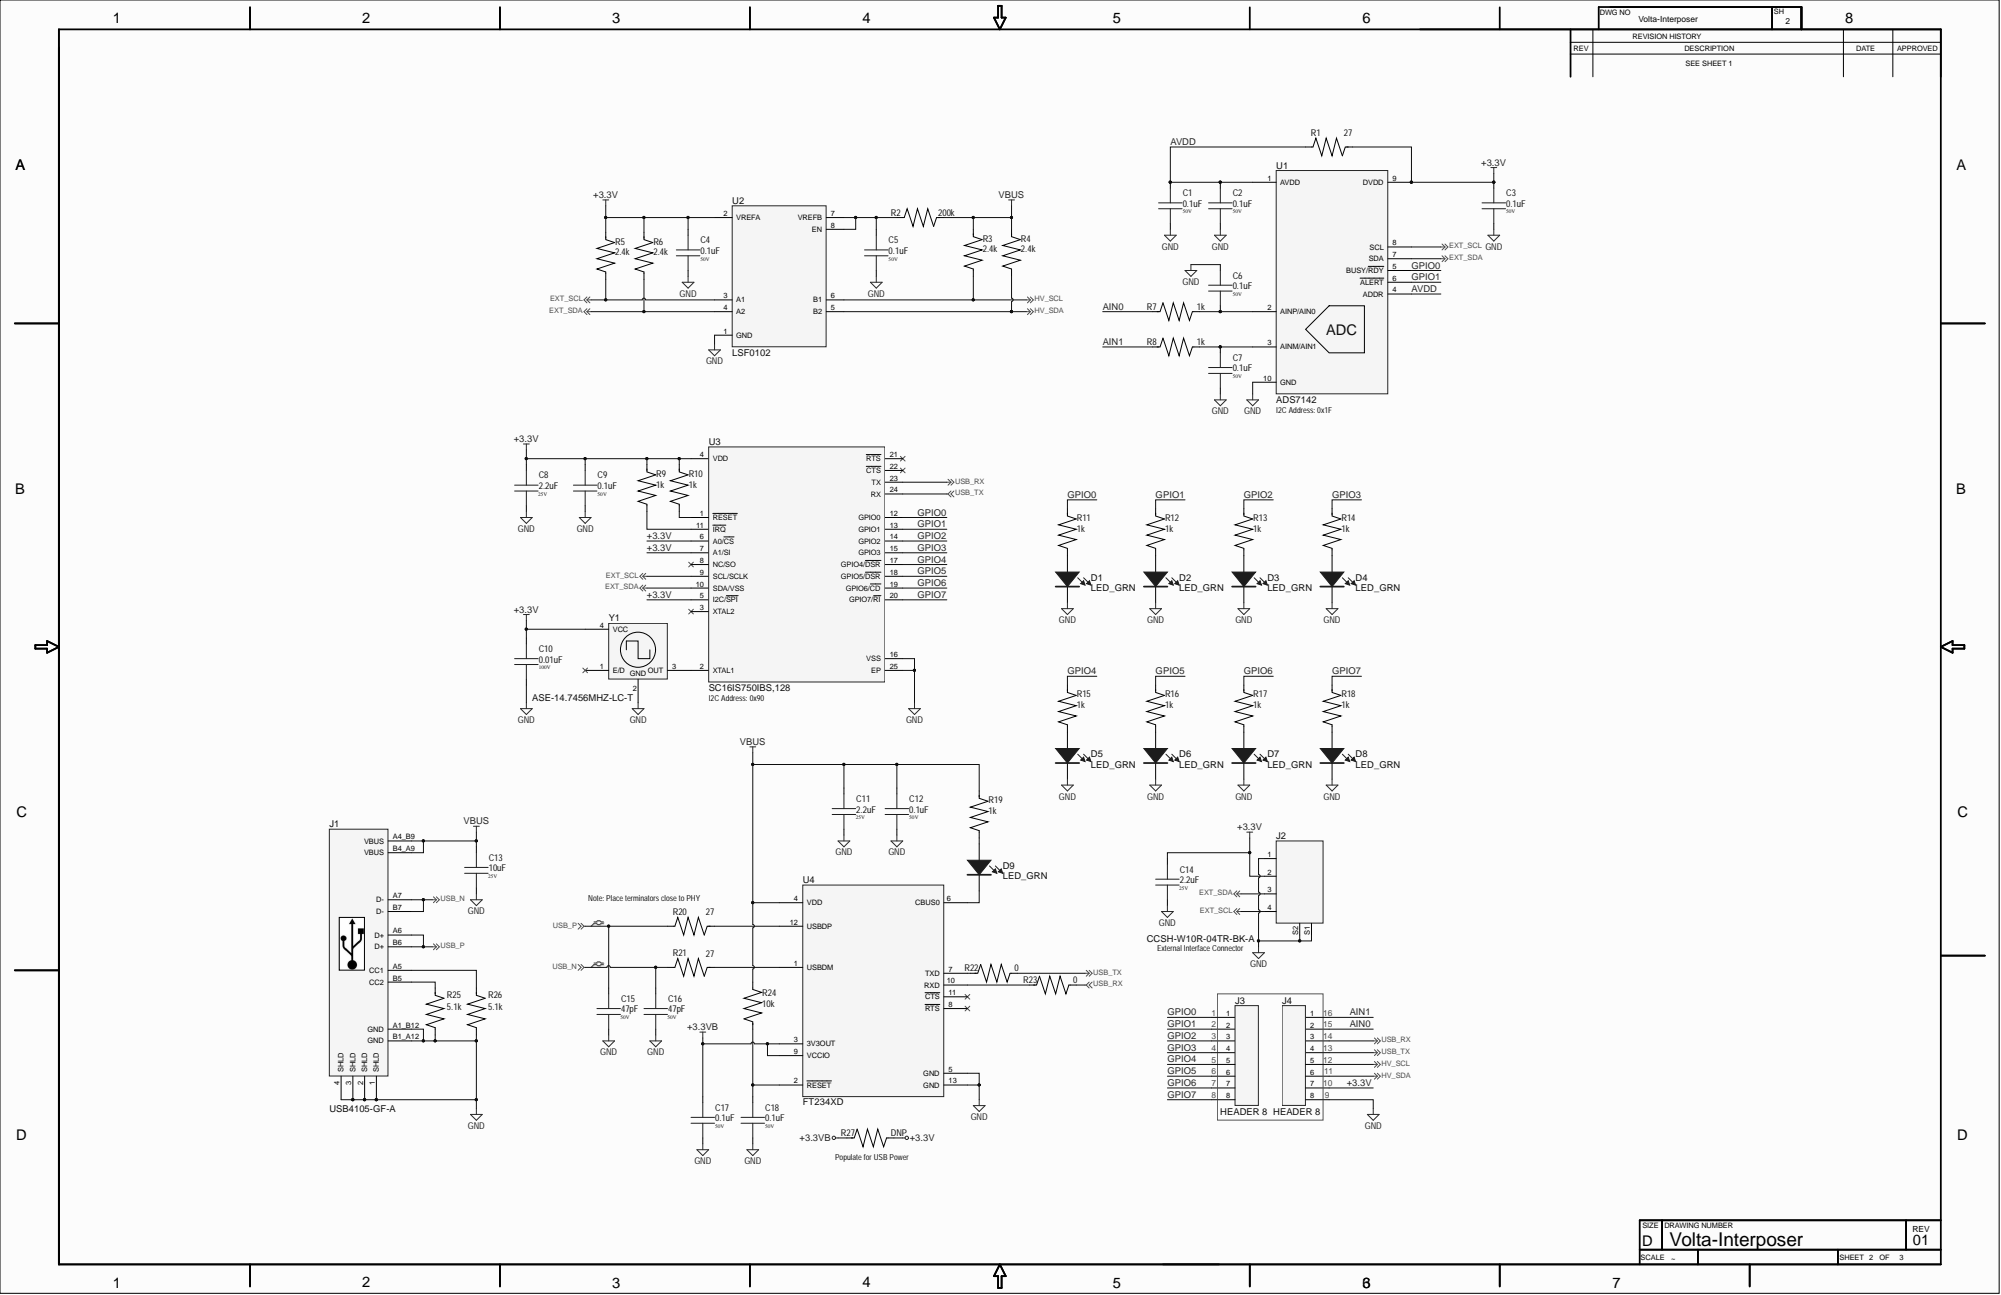
[picture p7: page 2]

DWG NO Volta-Interposer | SH

R1 27 AVDD | | REVISION HISTORY

REV | DESCRIPTION | DATE | APPROVED

Note: Place terminators close to PHY

Populate for USB Power

SIZE D | DRAWING NUMBER Volta-Interposer | REV 01

SCALE ~ | | 2 3 SHEET OF
