kylerjkidd/Volta-Lab-Supply/Volta/Motherboard/REV 02/Volta-Motherboard-SCH_(02).pdf

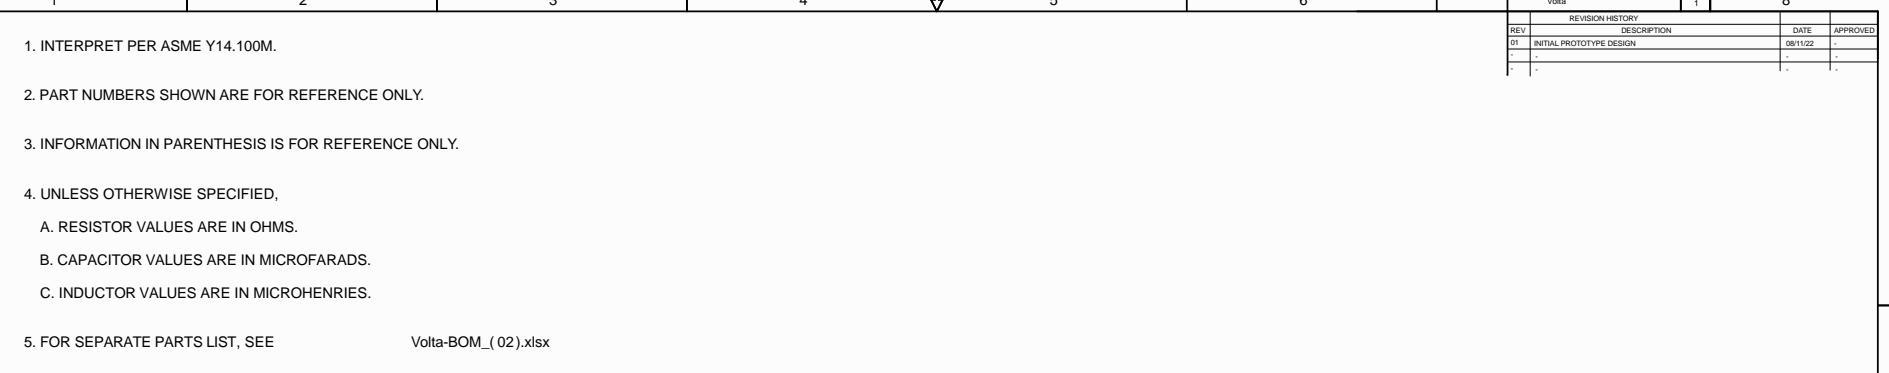
[picture p8: page 1]

DWG NO Volta | SH

REVISION HISTORY

REV | DESCRIPTION | DATE | APPROVED
01 | INITIAL PROTOTYPE DESIGN | 08/11/22 | -

2. PART NUMBERS SHOWN ARE FOR REFERENCE ONLY.

3. INFORMATION IN PARENTHESIS IS FOR REFERENCE ONLY.

A. RESISTOR VALUES ARE IN OHMS.

B. CAPACITOR VALUES ARE IN MICROFARADS.

C. INDUCTOR VALUES ARE IN MICROHENRIES.

5. FOR SEPARATE PARTS LIST, SEE

MATERIAL: | DO NOT SCALE DRAWING UNLESS OTHERWISE SPECIFIED, DIMENSIONS ARE IN TOLERANCES: .X +/- 0.1 .XX +/- 0.01 .XXX +/- 0.001 | DFTG | K. KIDD | 09/17/22

ENG | K. KIDD | 09/17/22
MECH | * | *

MFG | * | *

THIRD ANGLE PROJECTION | ALL SHEETS ARE THE SAME REVISION STATUS

SIZE D | DRAWING NUMBER Volta | REV 02

SCALE N/A | | 1 2 SHEET OF

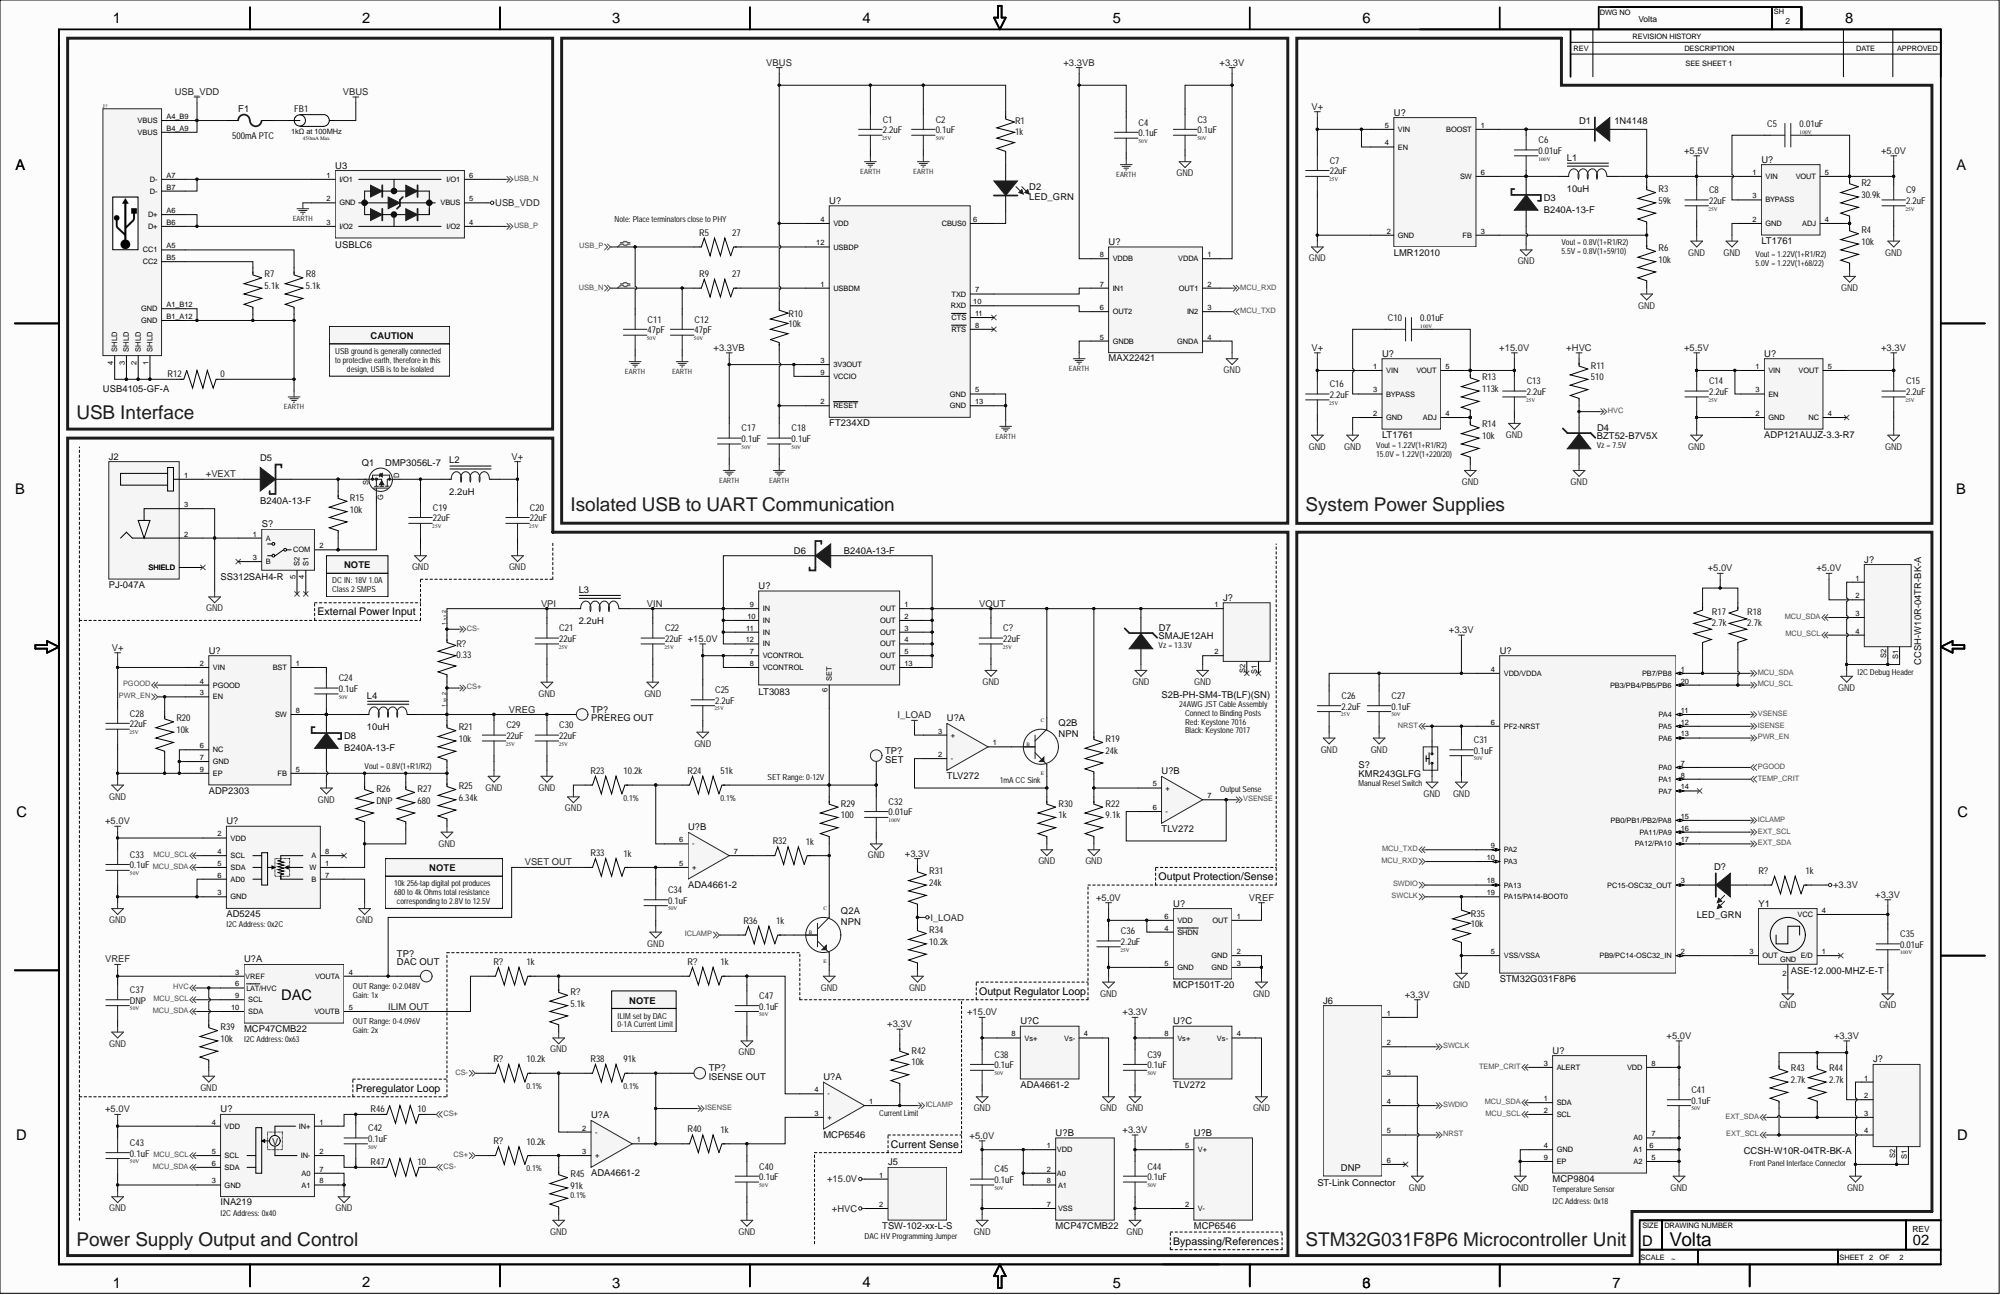
[picture p9: page 2]

DWG NO Volta | SH

REVISION HISTORY

REV | DESCRIPTION | DATE | APPROVED

Note: Place terminators close to PHY

USB ground is generally connected
to protective earth, therefore in this
design, USB is to be isolated

Isolated USB to UART Communication

24AWG JST Cable Assembly
Connect to Binding Posts
Red: Keystone 7016
Black: Keystone 7017

10k 256-tap digital pot produces
680 to 4k Ohms total resistance
corresponding to 2.8V to 12.5V

ILIM set by DAC
0-1A Current Limit

EXT_SCL
CCSH-W10R-04TR-BK-A
Front Panel Interface Connector

GND
Power Supply Output and Control

TSW-102-xx-L-S
DAC HV Programming Jumper
