kylerjkidd/Volta-Lab-Supply/Volta/Motherboard/REV A/Volta-Motherboard-SCH_(A).pdf

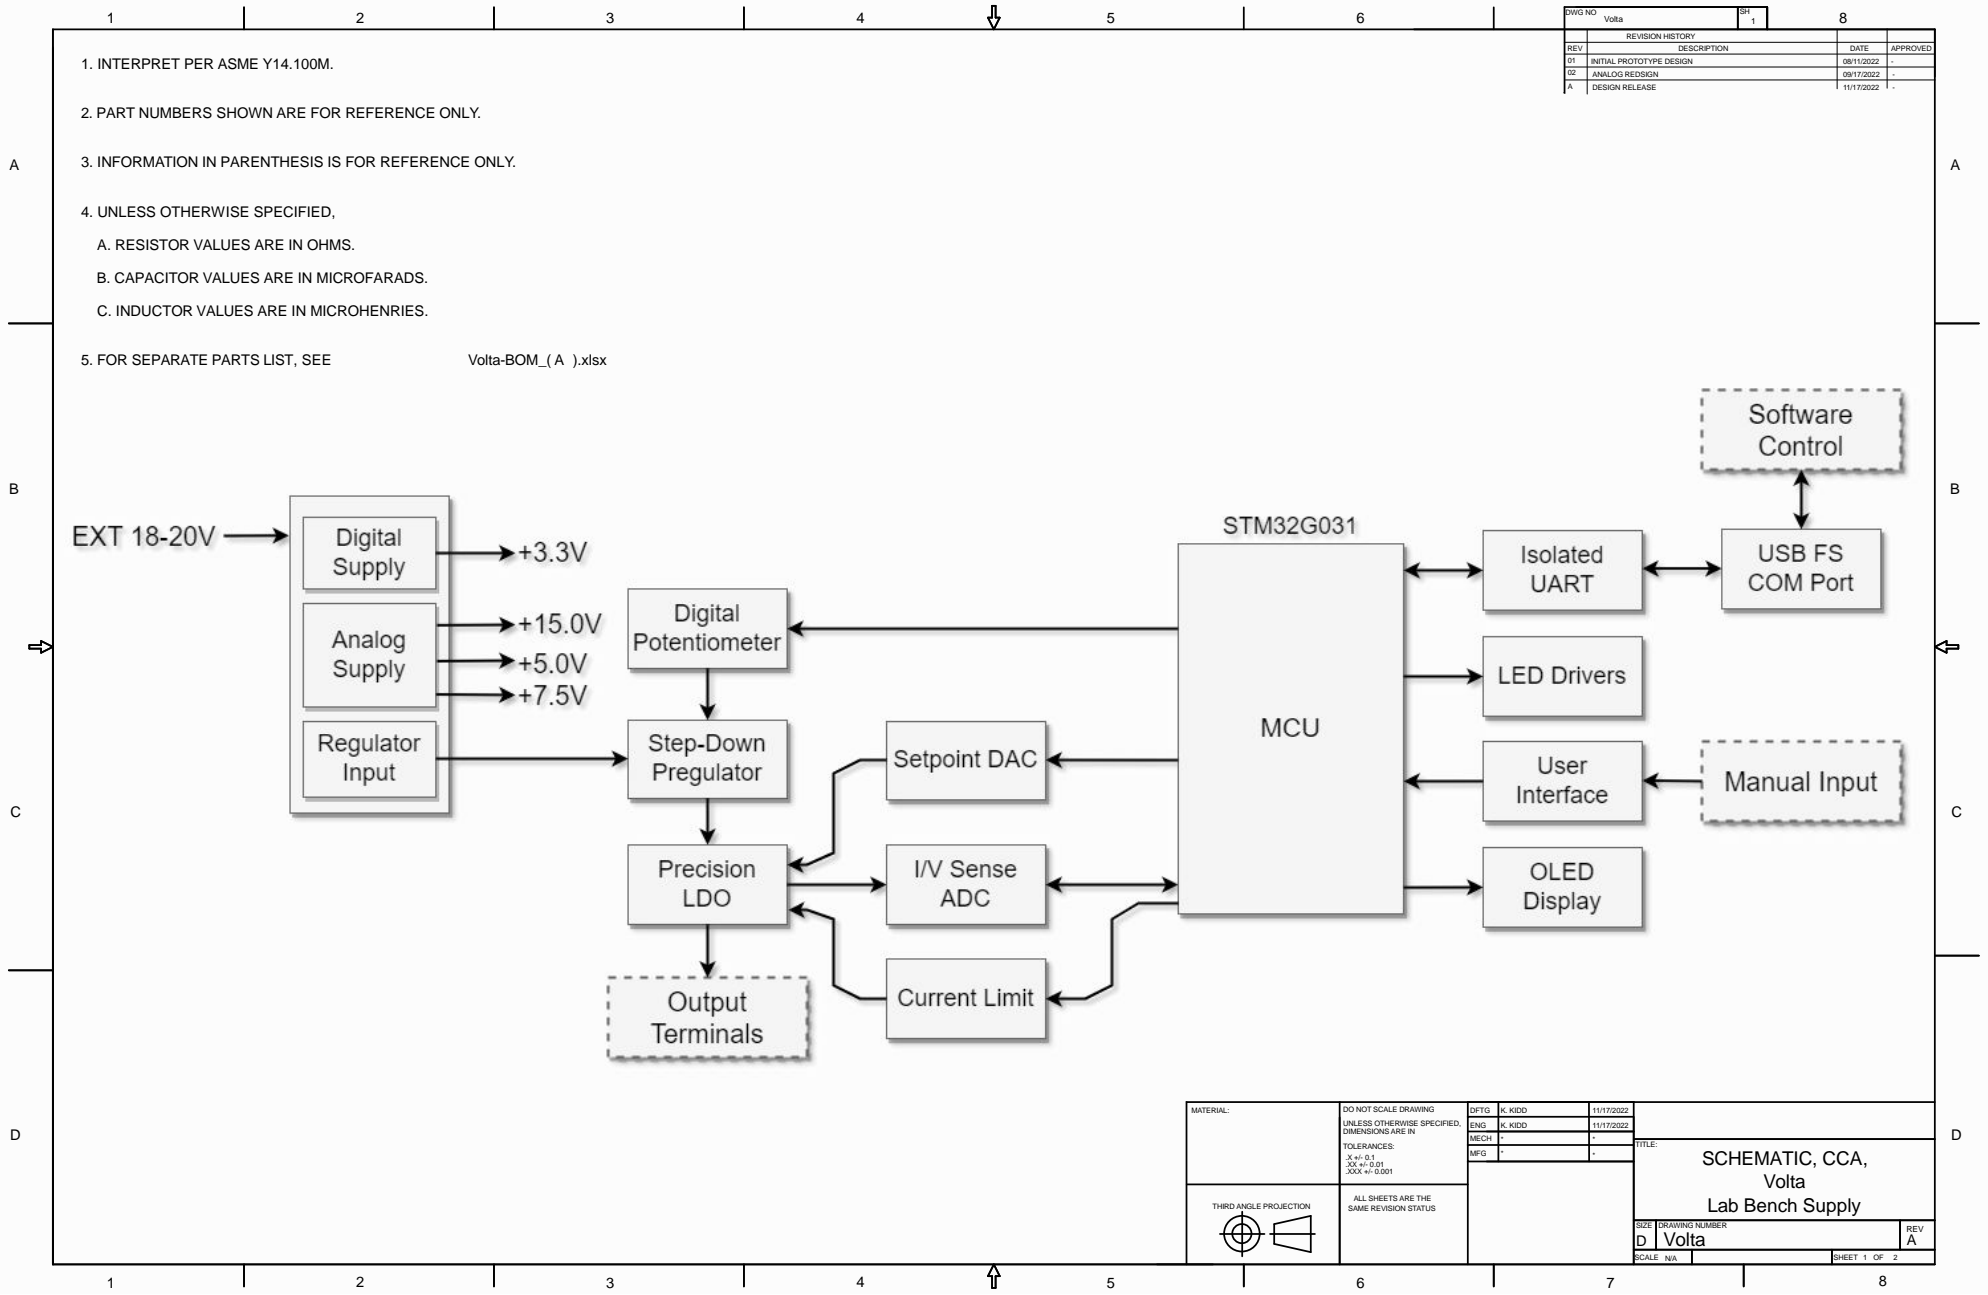
[picture p10: page 1]

DWG NO Volta | SH

REVISION HISTORY

REV | DESCRIPTION | DATE | APPROVED
01 | INITIAL PROTOTYPE DESIGN | 08/11/2022 | -
02 | ANALOG REDSIGN | 09/17/2022 | -

2. PART NUMBERS SHOWN ARE FOR REFERENCE ONLY.

3. INFORMATION IN PARENTHESIS IS FOR REFERENCE ONLY.

A. RESISTOR VALUES ARE IN OHMS.

B. CAPACITOR VALUES ARE IN MICROFARADS.

C. INDUCTOR VALUES ARE IN MICROHENRIES.

5. FOR SEPARATE PARTS LIST, SEE

MATERIAL: | DO NOT SCALE DRAWING UNLESS OTHERWISE SPECIFIED, DIMENSIONS ARE IN TOLERANCES: .X +/- 0.1 .XX +/- 0.01 .XXX +/- 0.001 | DFTG | K. KIDD | 11/17/2022

ENG | K. KIDD | 11/17/2022
MECH | * | *

MFG | * | *

THIRD ANGLE PROJECTION | ALL SHEETS ARE THE SAME REVISION STATUS

SIZE D | DRAWING NUMBER Volta | REV A

SCALE N/A | | 1 2 SHEET OF

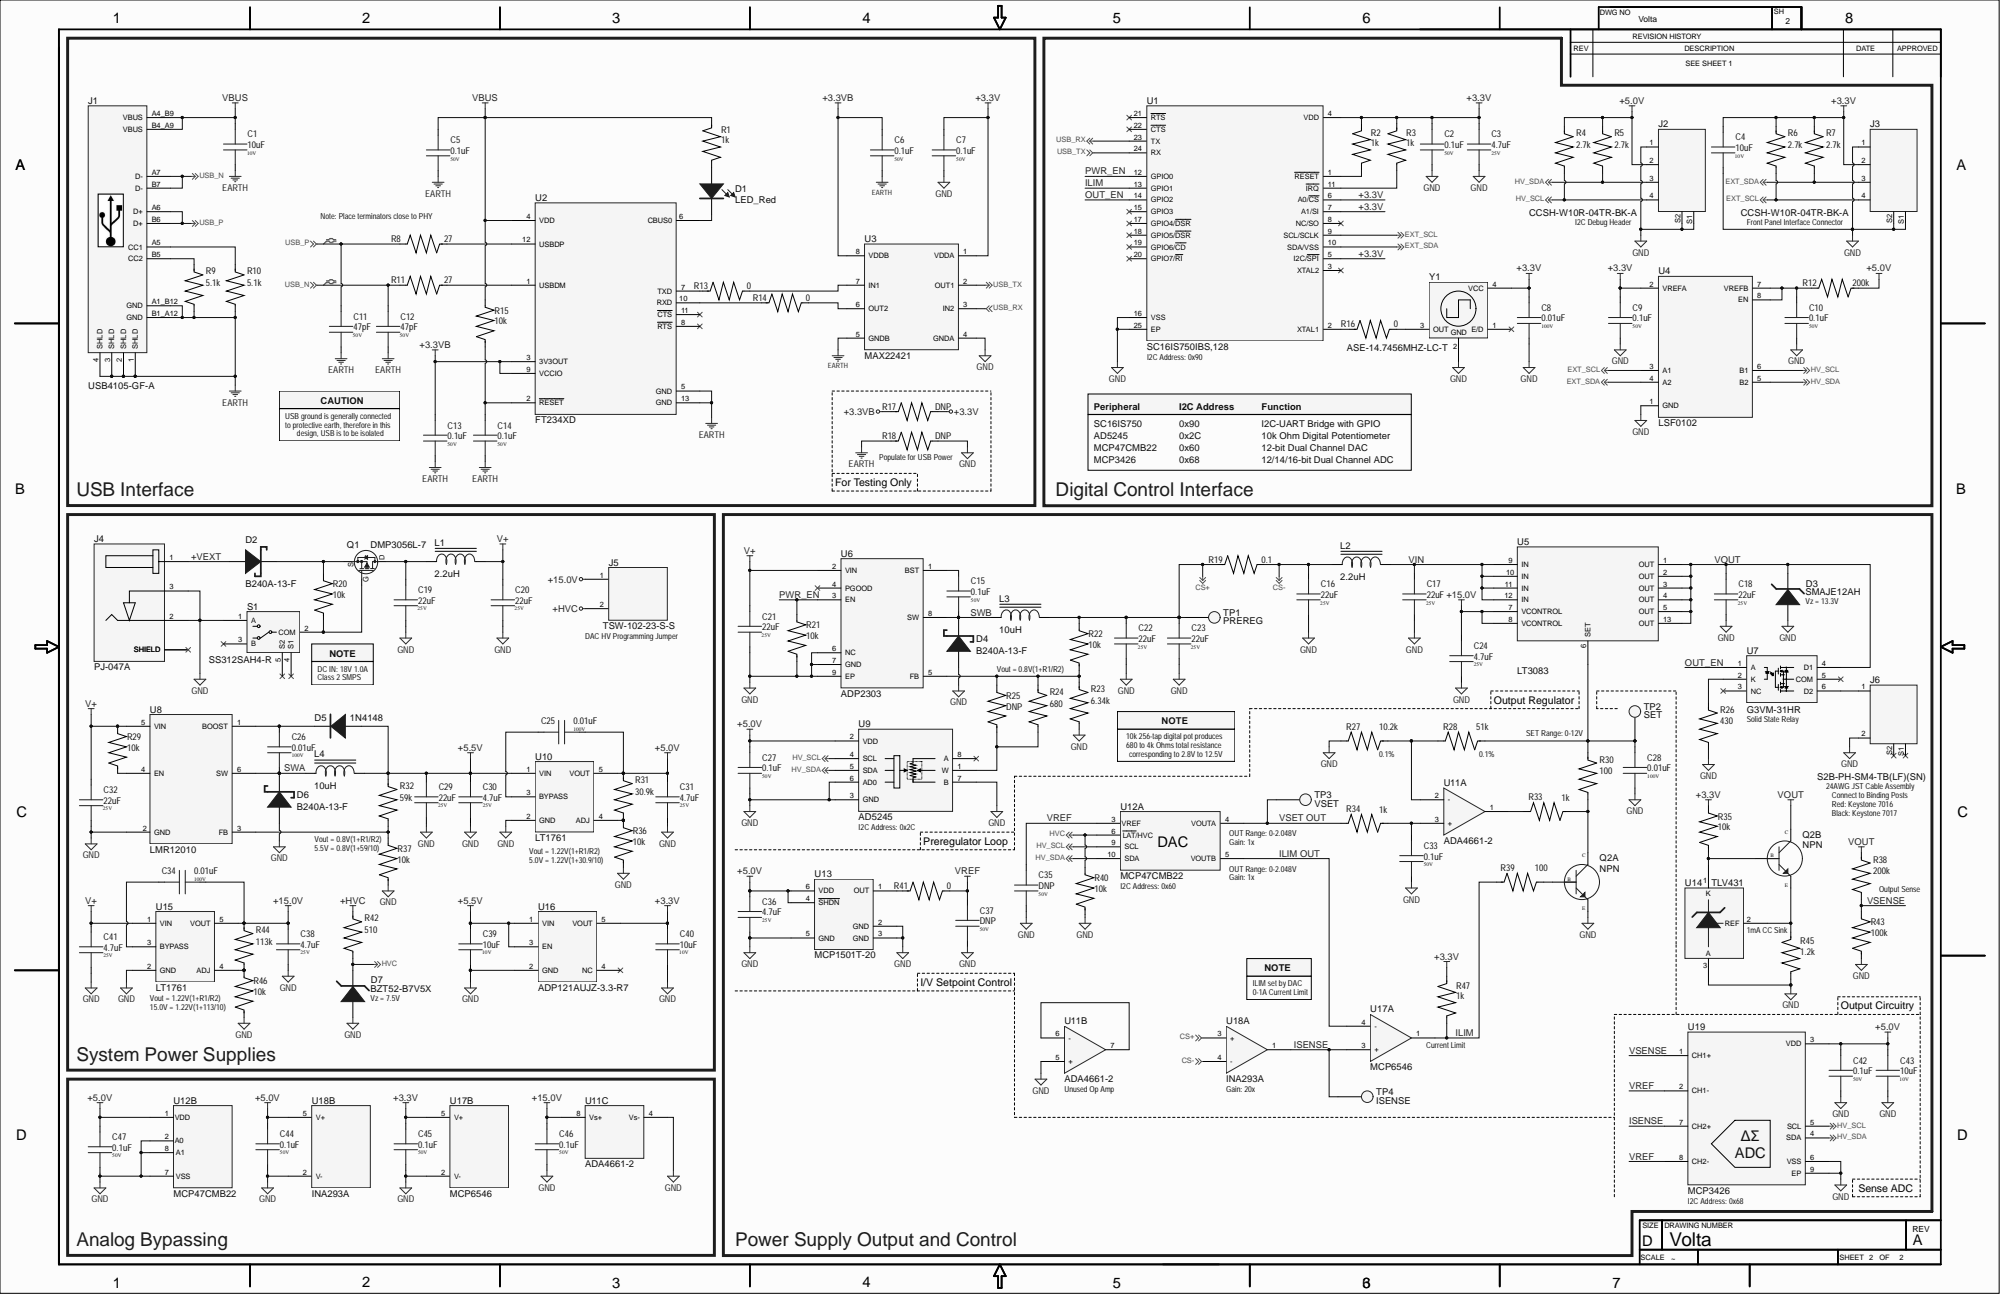
[picture p11: page 2]

DWG NO Volta | SH

REVISION HISTORY

REV | DESCRIPTION | DATE | APPROVED

EXT_SCL
CCSH-W10R-04TR-BK-A
Front Panel Interface Connector

Note: Place terminators close to PHY

USB ground is generally connected
to protective earth, therefore in this
design, USB is to be isolated

I2C-UART Bridge with GPIO
10k Ohm Digital Potentiometer
12-bit Dual Channel DAC
12/14/16-bit Dual Channel ADC

Populate for USB Power

TSW-102-23-S-S
DAC HV Programming Jumper

10k 256-tap digital pot produces
680 to 4k Ohms total resistance
corresponding to 2.8V to 12.5V

GND
24AWG JST Cable Assembly
Connect to Binding Posts
Red: Keystone 7016

ILIM set by DAC
0-1A Current Limit

SIZE D | DRAWING NUMBER Volta | REV A

Power Supply Output and Control

SCALE ~ | | 2 2 SHEET OF
