kylerjkidd/Volta-Lab-Supply/Volta/Interface/REV A/Volta-Interface-SCH_(A).pdf

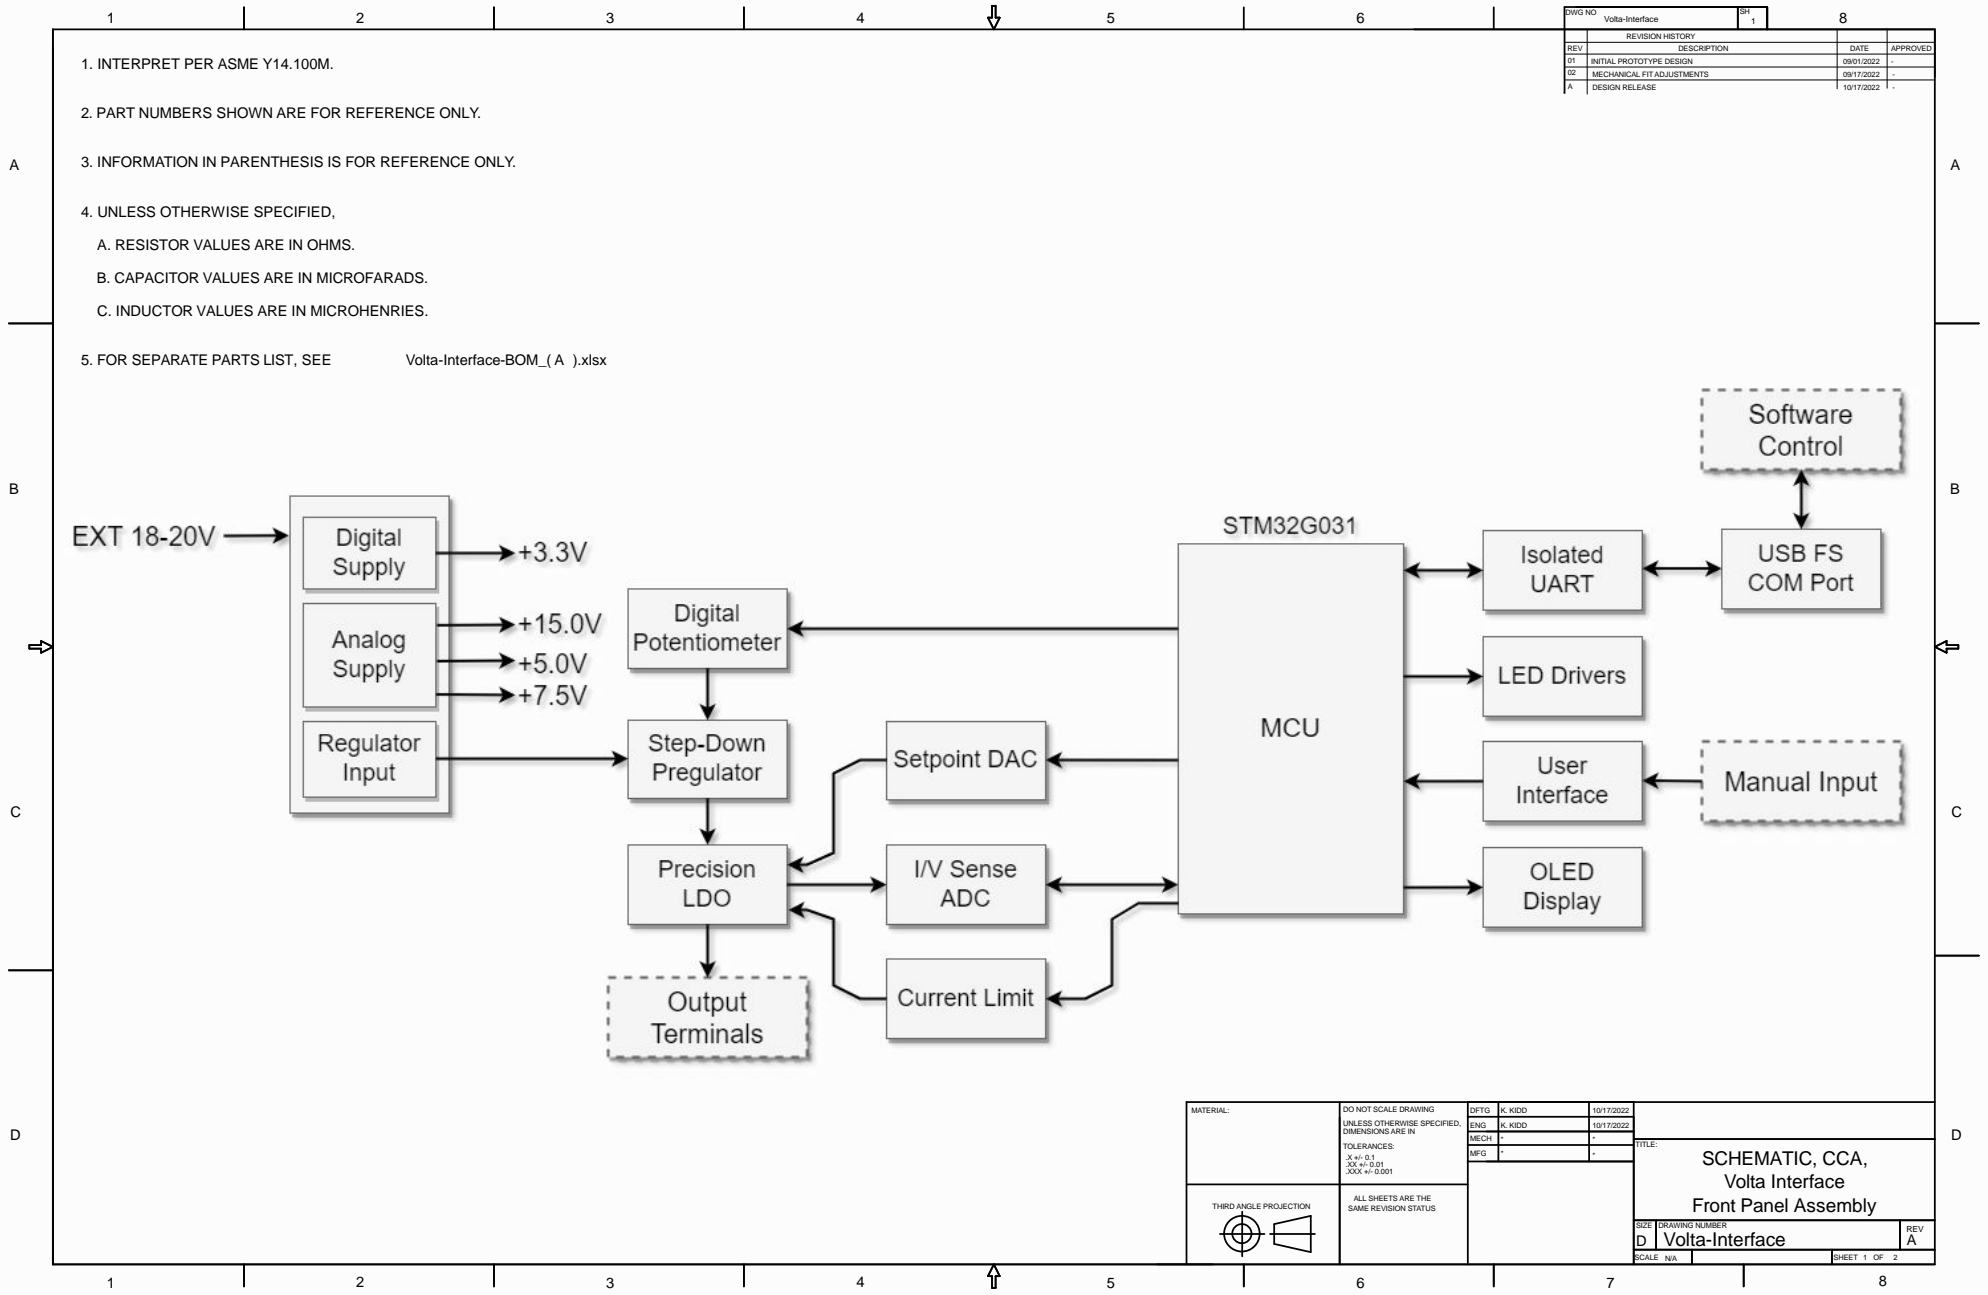
[picture p14: page 1]

DWG NO Volta-Interface | SH

REVISION HISTORY

REV | DESCRIPTION | DATE | APPROVED
01 | INITIAL PROTOTYPE DESIGN | 09/01/2022 | -
02 | MECHANICAL FIT ADJUSTMENTS | 09/17/2022 | -

2. PART NUMBERS SHOWN ARE FOR REFERENCE ONLY.

3. INFORMATION IN PARENTHESIS IS FOR REFERENCE ONLY.

A. RESISTOR VALUES ARE IN OHMS.

B. CAPACITOR VALUES ARE IN MICROFARADS.

C. INDUCTOR VALUES ARE IN MICROHENRIES.

5. FOR SEPARATE PARTS LIST, SEE

MATERIAL: | DO NOT SCALE DRAWING UNLESS OTHERWISE SPECIFIED, DIMENSIONS ARE IN TOLERANCES: .X +/- 0.1 .XX +/- 0.01 .XXX +/- 0.001 | DFTG | K. KIDD | 10/17/2022

ENG | K. KIDD | 10/17/2022
MECH | * | *

MFG | * | *

THIRD ANGLE PROJECTION | ALL SHEETS ARE THE SAME REVISION STATUS

SIZE D | DRAWING NUMBER Volta-Interface | REV A

SCALE N/A | | 1 2 SHEET OF

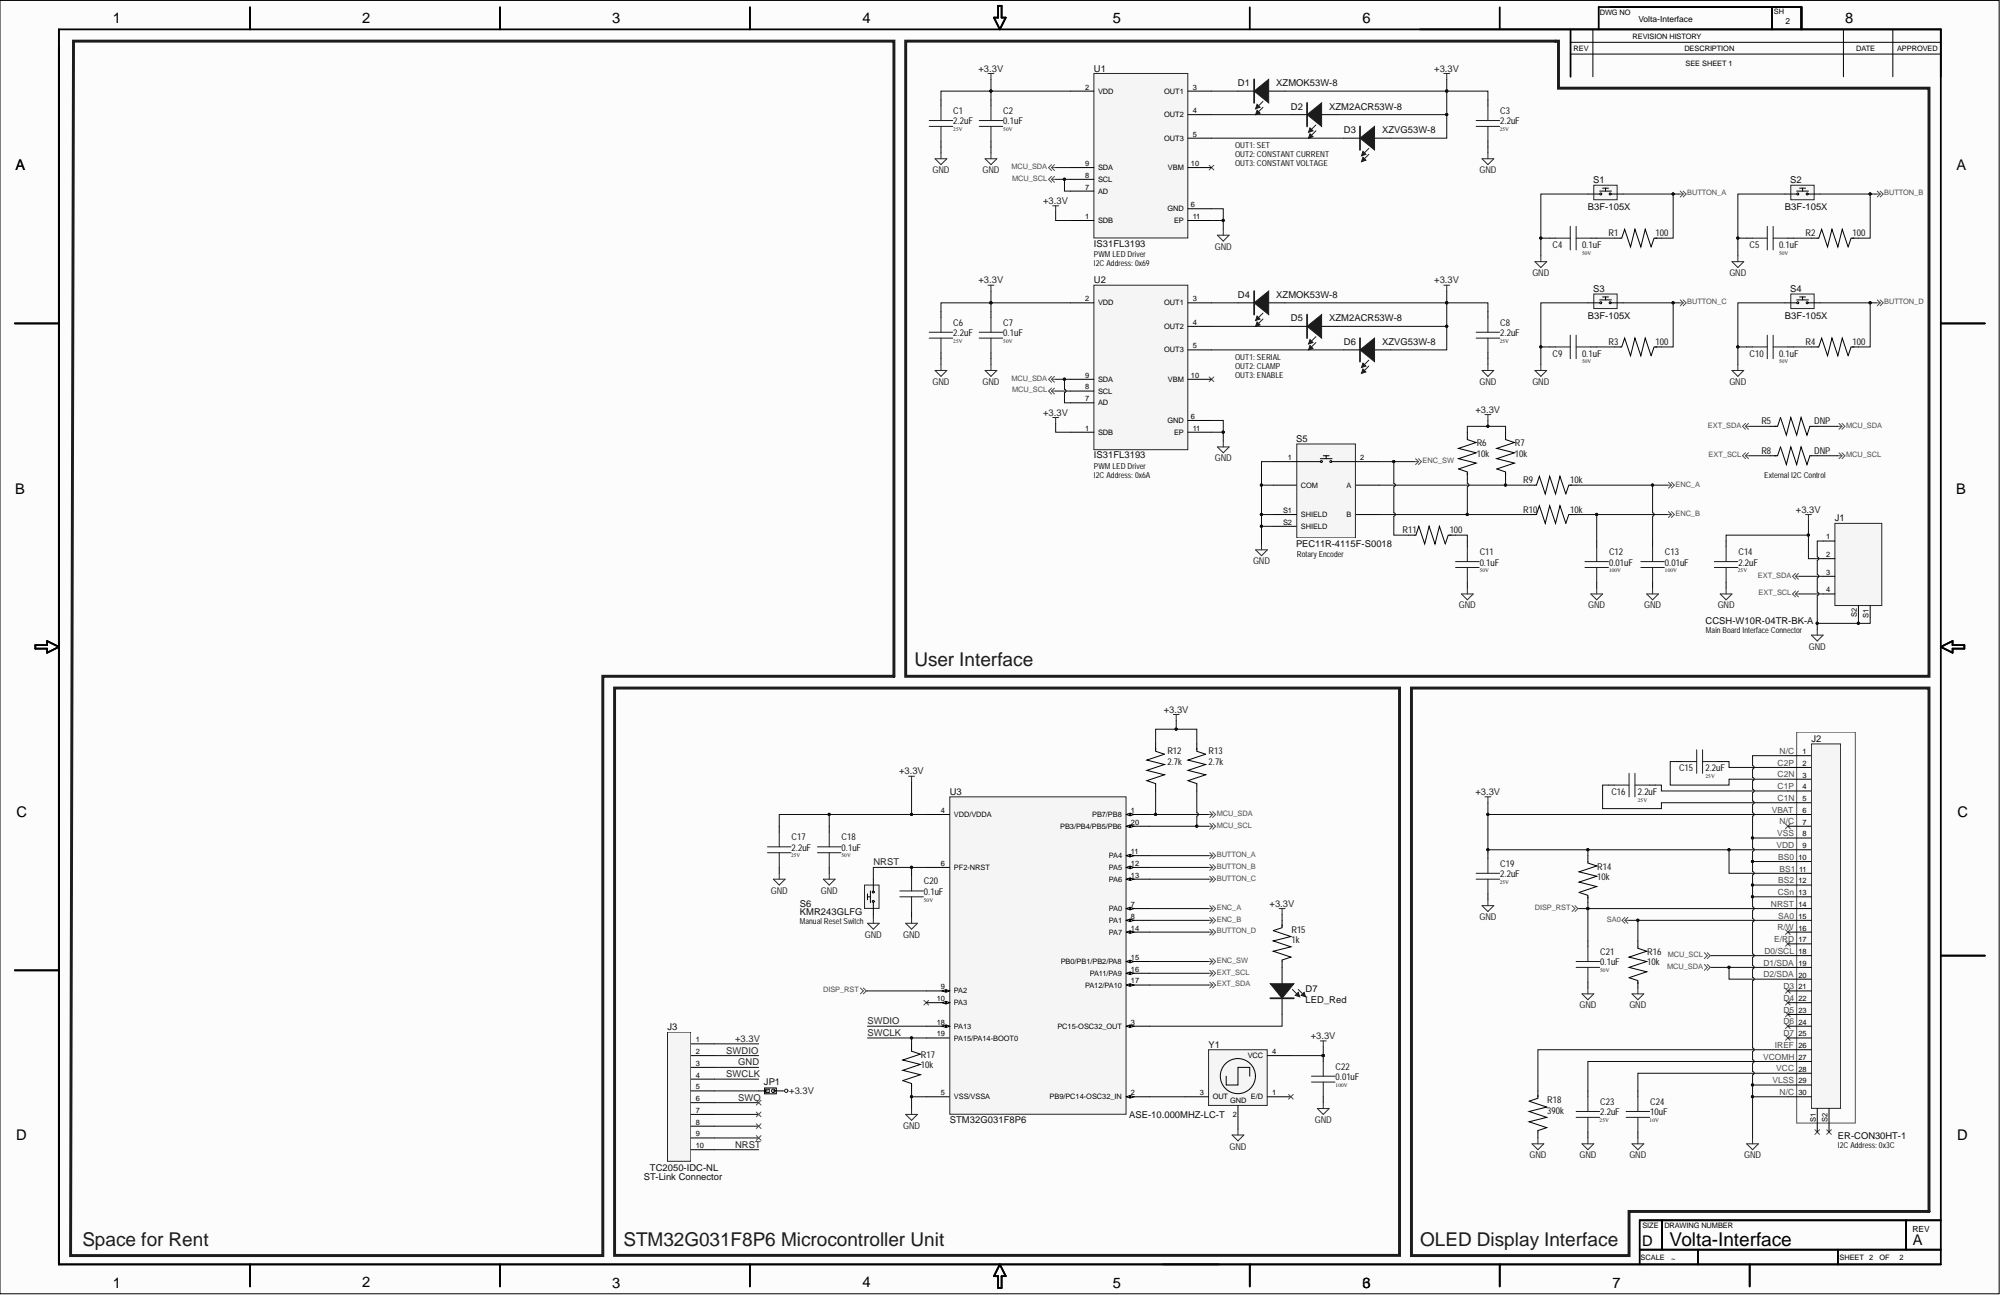
[picture p15: page 2]

DWG NO Volta-Interface | SH

REVISION HISTORY

REV | DESCRIPTION | DATE | APPROVED

GND
CCSH-W10R-04TR-BK-A
Main Board Interface Connector

C2P
C2N | 3
C1P
C1N | 5
VBAT | 6

VDD | 9
BS0 | 10
BS1 | 11
BS2 | 12
CSn | 13
14 15 16

VCC | 28
VLSS | 29

SIZE D | DRAWING NUMBER Volta-Interface | REV A

SCALE ~ | | 2 2 SHEET OF
