kylerjkidd/Volta-Lab-Supply/Volta/Motherboard/REV 01/NIR-Spec-Motherboard-SCH_(01).pdf

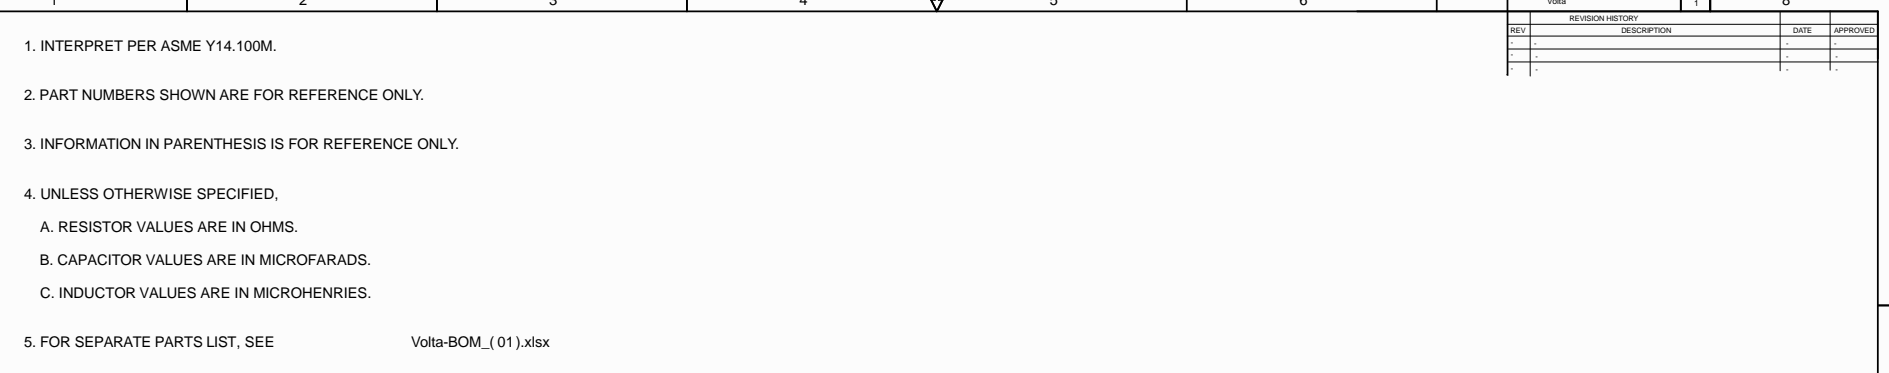
[picture p16: page 1]

DWG NO Volta | SH

REVISION HISTORY

REV | DESCRIPTION | DATE | APPROVED
- | - | - -

2. PART NUMBERS SHOWN ARE FOR REFERENCE ONLY.

3. INFORMATION IN PARENTHESIS IS FOR REFERENCE ONLY.

A. RESISTOR VALUES ARE IN OHMS.

B. CAPACITOR VALUES ARE IN MICROFARADS.

C. INDUCTOR VALUES ARE IN MICROHENRIES.

5. FOR SEPARATE PARTS LIST, SEE

MATERIAL: | DO NOT SCALE DRAWING UNLESS OTHERWISE SPECIFIED, DIMENSIONS ARE IN TOLERANCES: .X +/- 0.1 .XX +/- 0.01 .XXX +/- 0.001 | DFTG | K. KIDD | -

ENG | K. KIDD | -
MECH | * | *

MFG | * | *

THIRD ANGLE PROJECTION | ALL SHEETS ARE THE SAME REVISION STATUS

SIZE D | DRAWING NUMBER Volta | REV 01

SCALE N/A | | SHEET OF

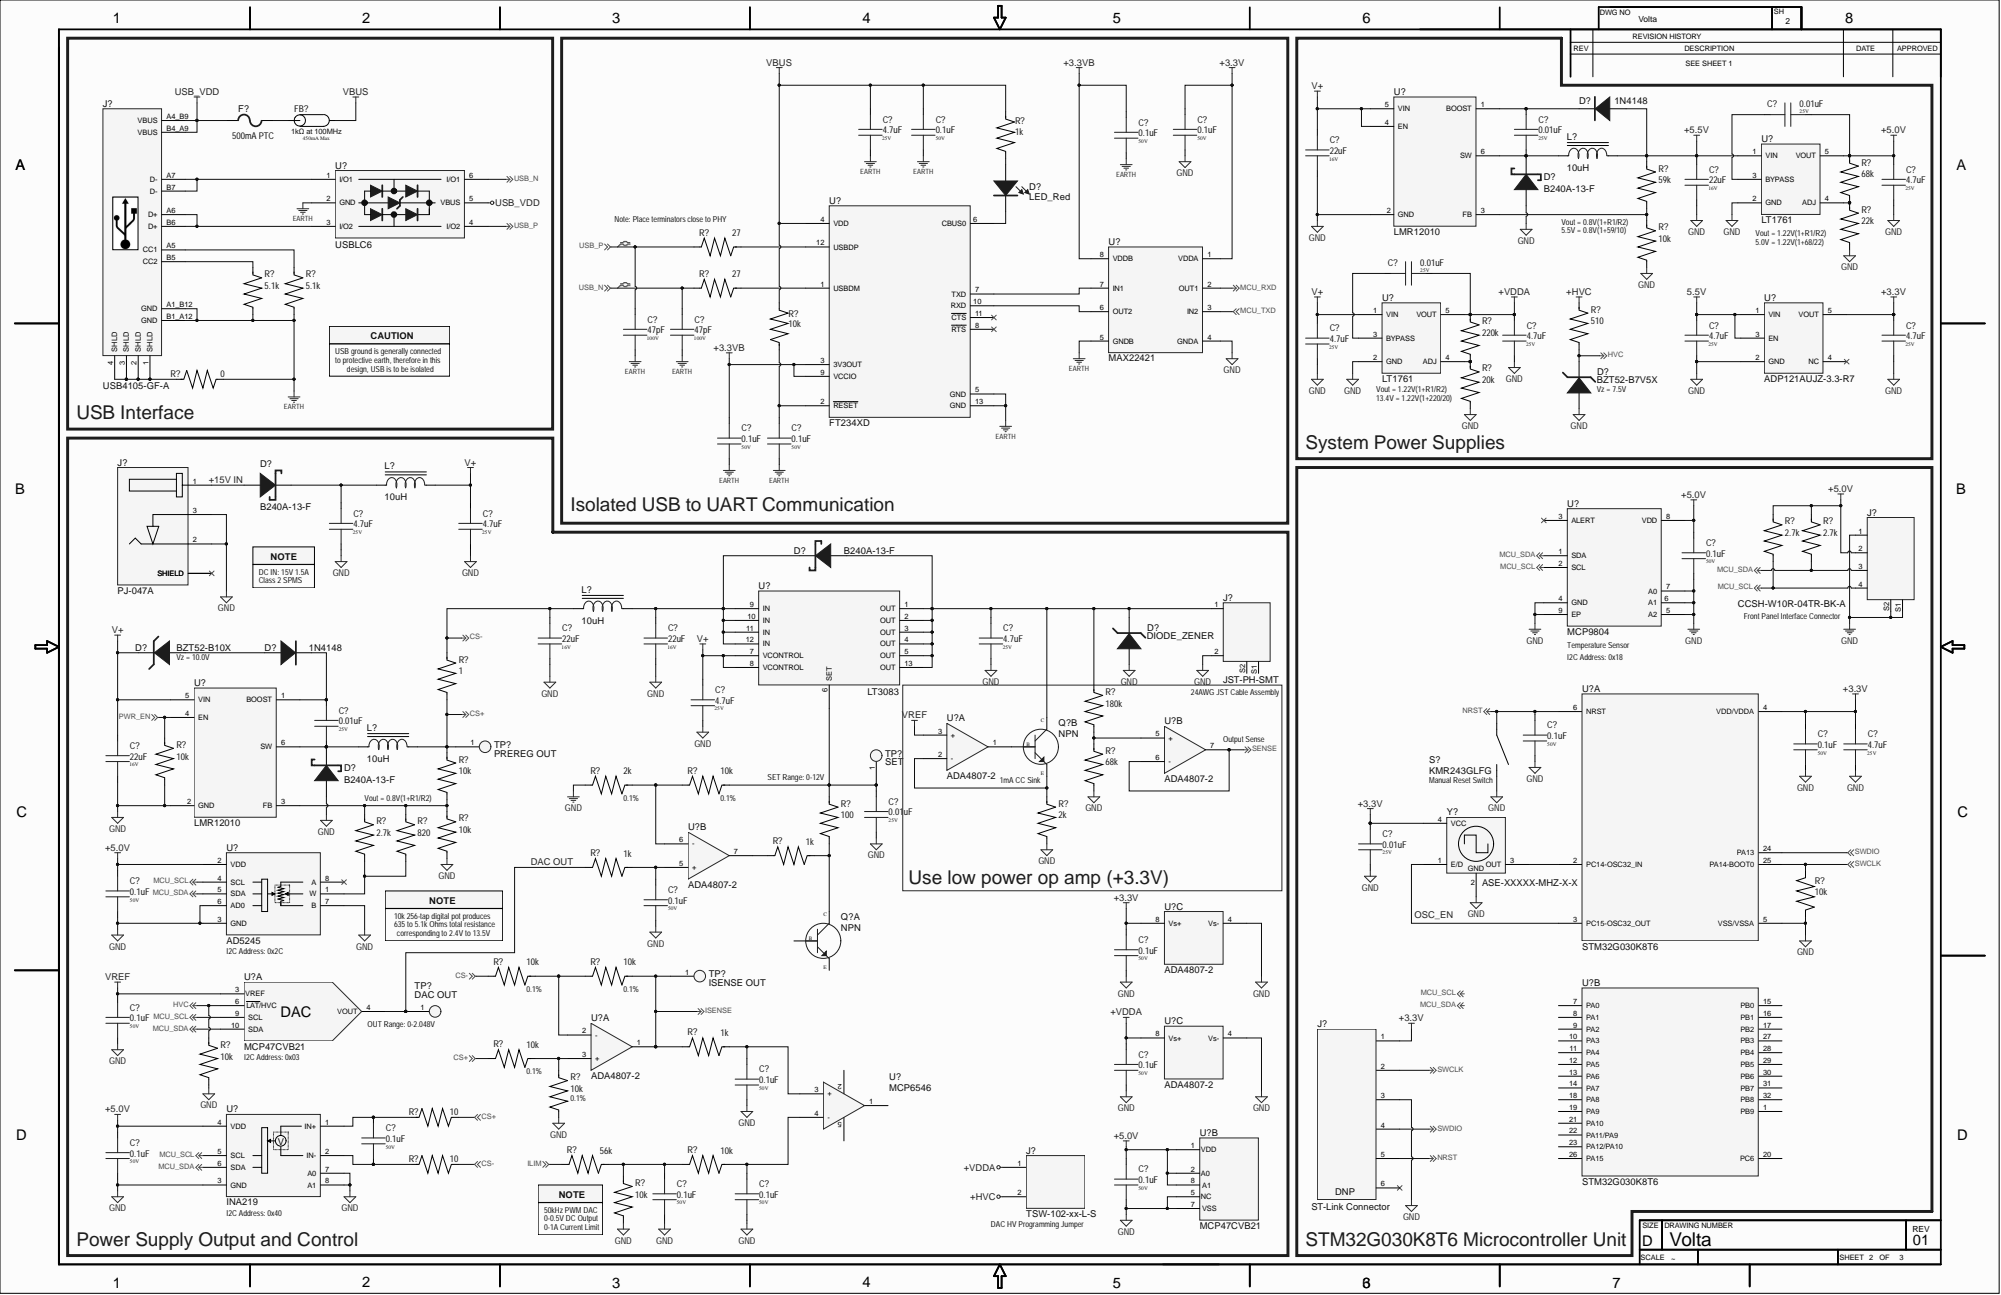
[picture p17: page 2]

Note: Place terminators close to PHY

USB ground is generally connected
to protective earth, therefore in this
design, USB is to be isolated

Isolated USB to UART Communication

MCU_SCL
CCSH-W10R-04TR-BK-A
Front Panel Interface Connector

GND
Use low power op amp (+3.3V)

10k 256-tap digital pot produces
635 to 5.1k Ohms total resistance
corresponding to 2.4V to 13.5V

Power Supply Output and Control

DAC HV Programming Jumper

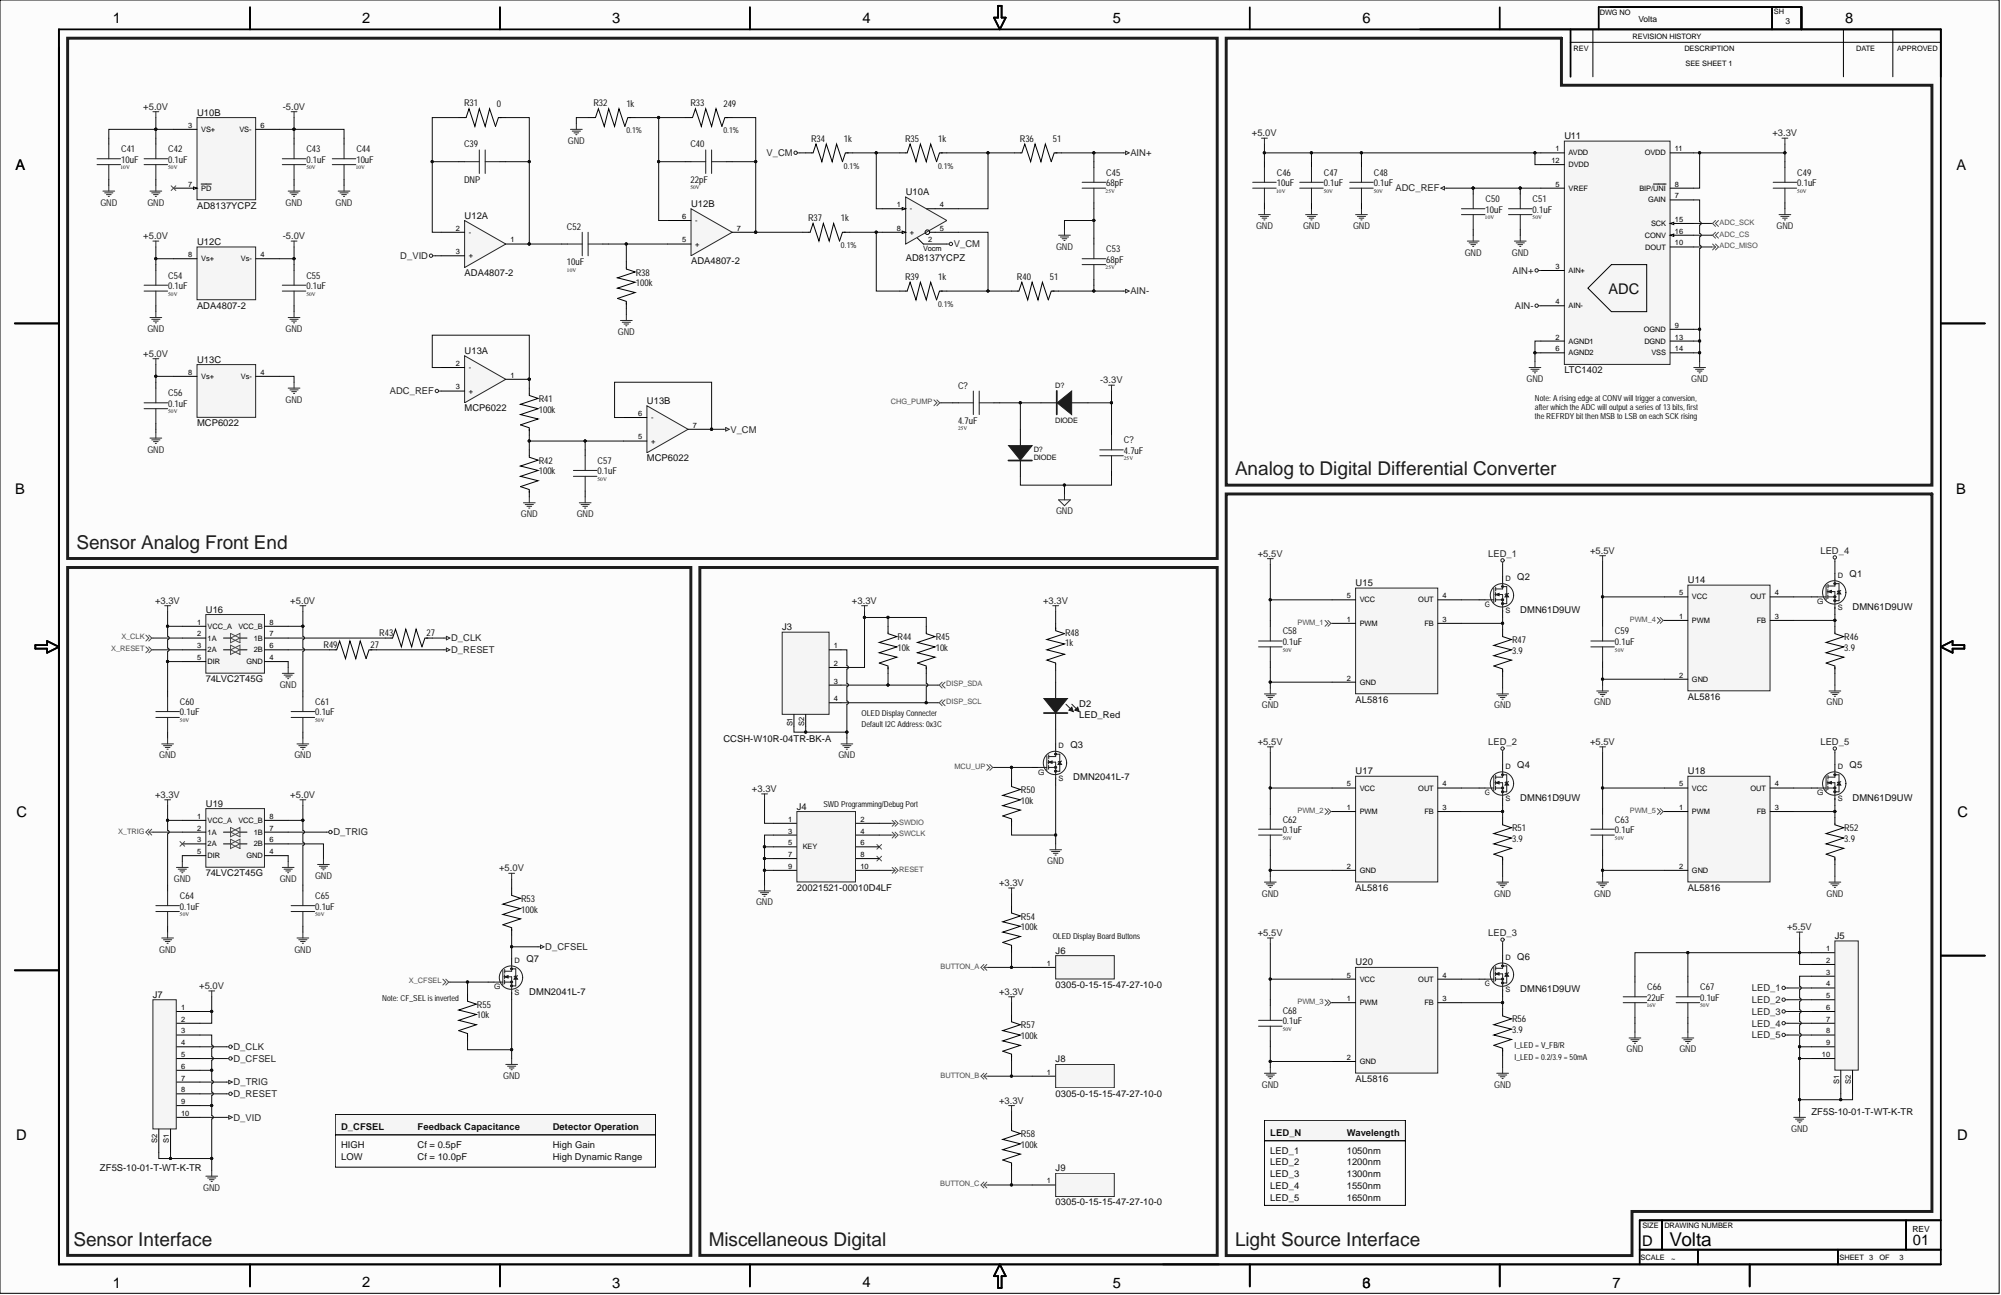
[picture p18: page 3]

Note: A rising edge at CONV will trigger a conversion,
after which the ADC will output a series of 13 bits, first
the REFRDY bit then MSB to LSB on each SCK rising

Analog to Digital Differential Converter

Sensor Analog Front End

SWD Programming/Debug Port

OLED Display Board Buttons
