kylerjkidd/Volta-Lab-Supply/Volta/Interface/REV 01/Volta-Interface-SCH_(01).pdf

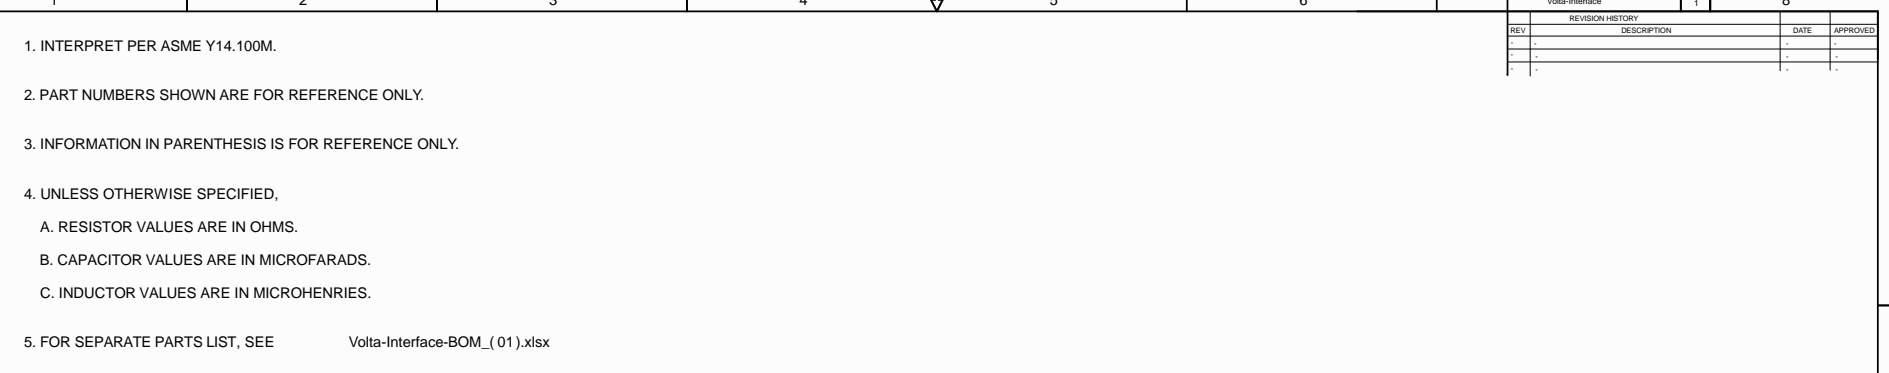
[picture p19: page 1]

DWG NO Volta-Interface | SH

REVISION HISTORY

REV | DESCRIPTION | DATE | APPROVED
- | - | - -

2. PART NUMBERS SHOWN ARE FOR REFERENCE ONLY.

3. INFORMATION IN PARENTHESIS IS FOR REFERENCE ONLY.

A. RESISTOR VALUES ARE IN OHMS.

B. CAPACITOR VALUES ARE IN MICROFARADS.

C. INDUCTOR VALUES ARE IN MICROHENRIES.

5. FOR SEPARATE PARTS LIST, SEE

MATERIAL: | DO NOT SCALE DRAWING UNLESS OTHERWISE SPECIFIED, DIMENSIONS ARE IN TOLERANCES: .X +/- 0.1 .XX +/- 0.01 .XXX +/- 0.001 | DFTG | K. KIDD | -

ENG | K. KIDD | -
MECH | * | *

MFG | * | *

THIRD ANGLE PROJECTION | ALL SHEETS ARE THE SAME REVISION STATUS

SIZE D | DRAWING NUMBER Volta-Interface | REV 01

SCALE N/A | | 1 3 SHEET OF

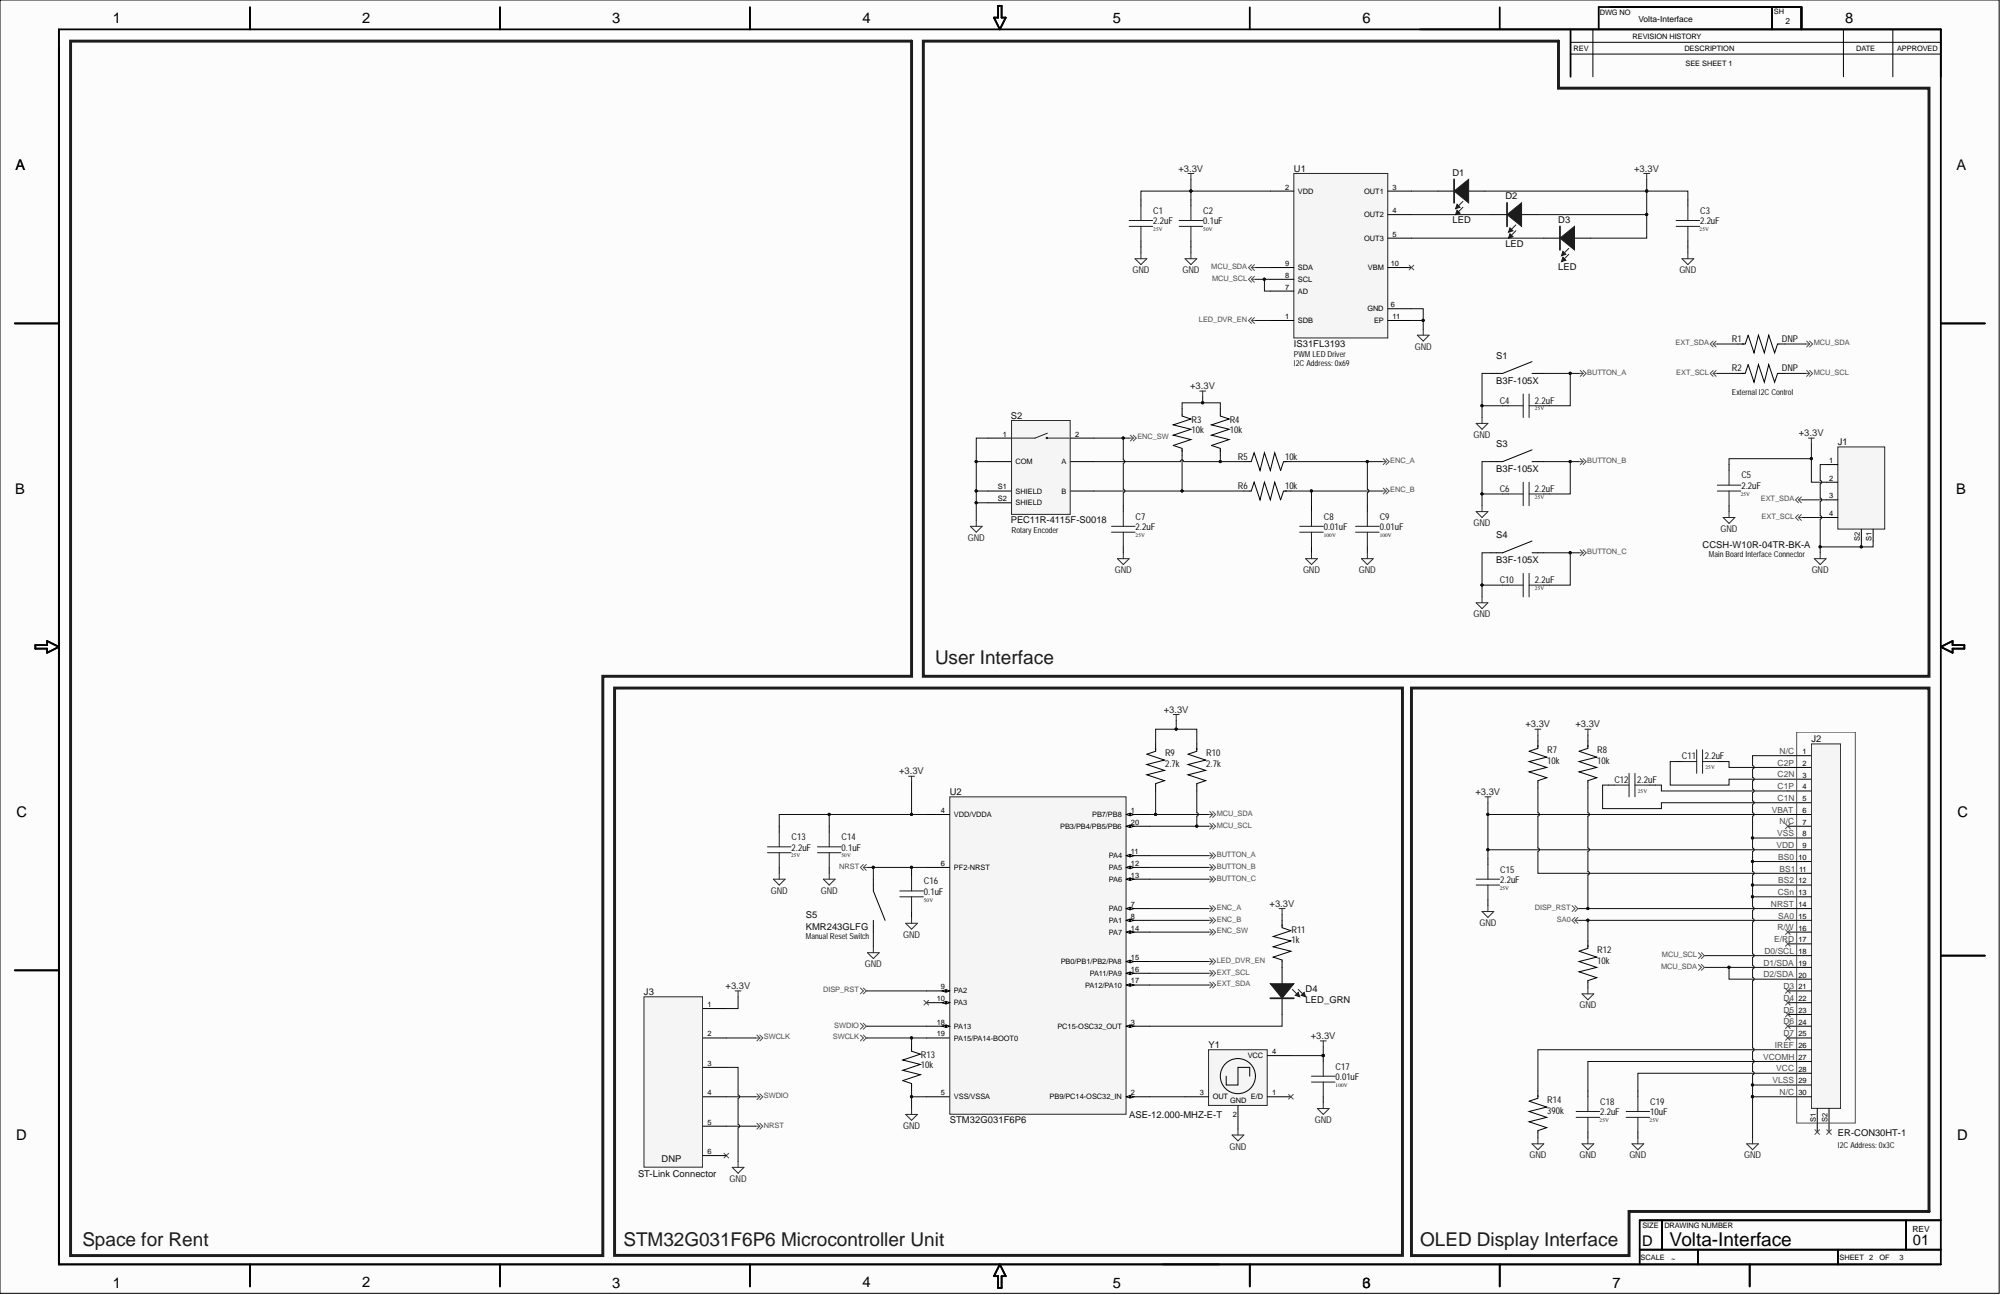
[picture p20: page 2]

DWG NO Volta-Interface | SH

REVISION HISTORY

REV | DESCRIPTION | DATE | APPROVED

GND
CCSH-W10R-04TR-BK-A
Main Board Interface Connector

C2P
C2N | 3
C1P
C1N | 5
VBAT | 6

VDD | | 9
BS0
10
BS1 | 11
BS2 | 12
CSn | 13
14 15 16

VCC | 28
VLSS | 29

SIZE D | DRAWING NUMBER Volta-Interface | REV 01

SCALE ~ | | 2 3 SHEET OF
