kylerjkidd/Volta-Lab-Supply/(list of files, drawings)

Other design files:
Volta/Interface/REV 01/Volta-Inteface.PrjPcb
Volta/Interface/REV 01/Volta-Interface-SCH_SH1_(01).SchDoc
Volta/Interface/REV 01/Volta-Interface-SCH_SH2_(01).SchDoc
Volta/Interface/REV 01/Volta-Interface.PcbDoc
Volta/Interface/REV 02/Volta-Inteface.PrjPcb
Volta/Interface/REV 02/Volta-Interface-SCH_SH1_(02).SchDoc
Volta/Interface/REV 02/Volta-Interface-SCH_SH2_(02).SchDoc
Volta/Interface/REV 02/Volta-Interface.PcbDoc
Volta/Interface/REV A/Volta-Interface-SCH_SH1_(A).SchDoc
Volta/Interface/REV A/Volta-Interface-SCH_SH2_(A).SchDoc
Volta/Interface/REV A/Volta-Interface.PcbDoc
Volta/Interface/REV A/Volta-Interface.PrjPcb
Volta/Motherboard/REV 01/PowerSupply-Motherboard.PrjPcb
Volta/Motherboard/REV 02/PowerSupply-Motherboard.PrjPcb
Volta/Motherboard/REV 02/PowerSupply-SCH_SH1_(02).SchDoc
Volta/Motherboard/REV 02/PowerSupply-SCH_SH2_(02).SchDoc
Volta/Motherboard/REV A/PowerSupply-Motherboard.PrjPcb
Volta/Motherboard/REV A/PowerSupply-SCH_SH1_(A).SchDoc
Volta/Motherboard/REV A/PowerSupply-SCH_SH2_(A).SchDoc
