kylerjkidd/Volta-Lab-Supply/Volta/Firmware/Volta-Interface.ioc

Mcu.UserName=STM32G031F8Px
PA0.Signal=S_TIM2_CH1_ETR
PA1.Signal=S_TIM2_CH2
PA13.Signal=SYS_SWDIO
PA14-BOOT0.Signal=SYS_SWCLK
PA2.Signal=GPIO_Output
PA4.Signal=GPXTI4
PA5.Signal=GPXTI5
PA6.Signal=GPXTI6
PA7.Signal=GPXTI7
PA8.Signal=GPXTI8
PB6.Signal=I2C1_SCL
PB7.Signal=I2C1_SDA
